AN1ME2U/diploma/project/project.png

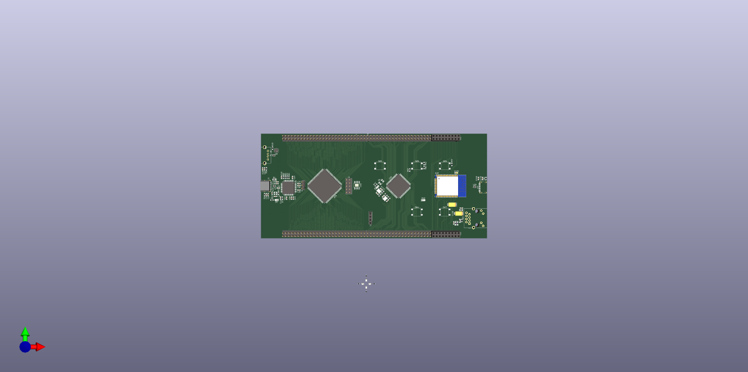
project/project.png
