AN1ME2U/diploma/(list of files, drawings)

Other design files:
project/atempt3.dsn
project/atempt4.dsn
project/atempt5.dsn
project/atempt6.dsn
project/atempt7.dsn
project/atempt8.dsn
project/atempt9.dsn
project/atempt10.dsn
project/atempt11.dsn
project/atempt12.dsn
project/atempt13.dsn
project/atempt14.dsn
project/atempt15.dsn
project/atempt16.dsn
project/project2.dsn
project/project.dsn
