AN1ME2U/diploma/project_old/project.kicad_pcb

## KiCad design project_old/project.kicad_pcb (2022-04-16, an earlier design)

Schematic: project.kicad_sch

Parts:
C1, C9, C10, C18, C19, C20, C21, C22, C24, C25, C26, C27, C28, C29, C30: 0.1u; C_0603_1608Metric_Pad1.08x0.95mm_HandSolder
C2, C3, C11, C12: 10u; CP_EIA-6032-15_Kemet-U_Pad2.25x2.35mm_HandSolder
C4, C23: 0.001u; C_0603_1608Metric_Pad1.08x0.95mm_HandSolder
C5, C6, C14, C15: 22u; CP_EIA-6032-15_Kemet-U_Pad2.25x2.35mm_HandSolder
C7, C8, C16, C17: 0.1u; C_0805_2012Metric_Pad1.18x1.45mm_HandSolder
C13: 1u; C_0603_1608Metric_Pad1.08x0.95mm_HandSolder
D1: D; D_0805_2012Metric_Pad1.15x1.40mm_HandSolder
D2: LED; LED_0805_2012Metric_Pad1.15x1.40mm_HandSolder
J1: USB_C_Receptacle_USB2.0; USB_C_Receptacle_HRO_TYPE-C-31-M-12
J2: Conn_01x03; PinHeader_1x03_P2.54mm_Vertical
J3: USB_A; USB_A_Molex_67643_Horizontal
L1, L2, L3, L4: 220; L_2010_5025Metric_Pad1.52x2.65mm_HandSolder
R1, R3, R9: 1M; R_0603_1608Metric_Pad0.98x0.95mm_HandSolder
R2, R4, R5, R6: 4.7k; R_0603_1608Metric_Pad0.98x0.95mm_HandSolder
R7: 9.53; R_0603_1608Metric_Pad0.98x0.95mm_HandSolder
R8: 4K; R_0603_1608Metric_Pad0.98x0.95mm_HandSolder
R10: 24k9; R_0603_1608Metric_Pad0.98x0.95mm_HandSolder
U1: AMS1117-5.0; SOT-223-3_TabPin2
U2, U5: AMS1117-3.3; SOT-223-3_TabPin2
U3, U7: USBLC6-2P6; SOT-666
U4: AMS1117-1.5; SOT-223-3_TabPin2
U6: TUSB4041I; HTQFP-64-1EP_10x10mm_P0.5mm_EP8x8mm_Mask4.4x4.4mm_ThermalVi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
U8: TPS2560; VSON-10-1EP_3x3mm_P0.5mm_EP1.65x2.4mm
Y1: Crystal_GND23; Crystal_SMD_2520-4Pin_2.5x2.0mm

Connections:
1V1_pereph: C24.1, C25.1, C26.1, C27.1, C28.1, C29.1, C30.1, U6.19 (VDD), U6.25 (VDD), U6.37 (VDD), U6.45 (VDD), U6.53 (VDD), U6.60 (VDD), U6.63 (VDD)
1V2_pereph: L3.2
3V3_header: L2.2; also elsewhere on the board
3V3_pereph: C18.1, C19.1, C20.1, C22.1, L4.2, U6.2 (VDD33), U6.20 (VDD33), U6.31 (VDD33), U6.48 (VDD33); also elsewhere on the board
5V_header: L1.2; also elsewhere on the board
+5V: C2.1, C3.1, C11.1, C12.1, D1.1 (K), R8.1, U1.3 (VI), U2.3 (VI), U3.5 (VBUS), U4.3 (VI), U5.3 (VI), U6.16 (USB_VBUS), U8.2 (IN), U8.3 (IN); also elsewhere on the board
/USB_MAIN_N: J1.A7 (D-), J1.B7 (D-), U3.3 (I/O2)
/USB_MAIN_P: J1.A6 (D+), J1.B6 (D+), U3.1 (I/O1)
GND: C1.2, C2.2, C3.2, C4.2, C5.2, C6.2, C7.2, C8.2, C9.2, C10.2, C11.2, C12.2, C13.1, C14.2, C15.2, C16.2, C17.2, C18.2, C19.2, C20.2, C21.2, C22.2, C23.2, C24.2, C25.2, C26.2, C27.2, C28.2, C29.2, C30.2, D2.1 (K), J1.A1 (GND), J1.A12 (GND), J1.B1 (GND), J1.B12 (GND), J3.4 (GND), R1.2, R2.2, R4.2, R5.2, R6.2, R7.2, R9.2, R10.2, U1.1 (GND), U2.1 (GND), U3.2 (GND), U4.1 (GND), U5.1 (GND), U6.65 (VSS), U7.2 (GND), U8.1 (GND), Y1.2, Y1.4; also elsewhere on the board
unnamed: C1.1, C4.1, J1.S1 (SHIELD), R1.1
unnamed: C5.1, C7.1, L1.1, U1.2 (VO)
unnamed: C6.1, C8.1, L2.1, U2.2 (VO)
unnamed: C9.1, R3.1, U6.30 (XI), Y1.1
unnamed: C10.1, R3.2, U6.29 (XO), Y1.3
unnamed: C13.2, U6.18 (GRSTz)
unnamed: C14.1, C16.1, L3.1, U4.2 (VO)
unnamed: C15.1, C17.1, L4.1, U5.2 (VO)
unnamed: C21.1, C23.1, J3.5 (Shield), R9.1
unnamed: D1.2 (A), J1.A4 (VBUS), J1.A9 (VBUS), J1.B4 (VBUS), J1.B9 (VBUS)
unnamed: D2.2 (A), R8.2
unnamed: J2.1, U6.7 (SMBUSz)
unnamed: J2.2, U6.6 (SCL/SMBCLK)
unnamed: J2.3, U6.5 (SDA/SMBDAT)
unnamed: R2.1, U6.10 (GANGED/SMBA2/HS_UP)
unnamed: R4.1, U6.8 (FULLPWRMGMTz/SMBA1)
unnamed: R5.1, U6.13 (AUTOENz/HS_SUSPEND)
unnamed: R6.1, U6.17 (TEST)
unnamed: R7.1, U6.32 (USB_R1)
unnamed: R10.1, U8.7 (ILM)
unnamed: U3.4 (I/O2), U6.22 (USB_DM_UP)
unnamed: U3.6 (I/O1), U6.21 (USB_DP_UP)
USB1_DN: U6.34 (USB_DM_DN1); also elsewhere on the board
USB1_DP: U6.33 (USB_DP_DN1); also elsewhere on the board
USB2_DN: U6.42 (USB_DM_DN2); also elsewhere on the board
USB2_DP: U6.41 (USB_DP_DN2); also elsewhere on the board
USB3_DN: U6.50 (USB_DM_DN3); also elsewhere on the board
USB3_DP: U6.49 (USB_DP_DN3); also elsewhere on the board
USB4_DN: J3.2 (D-), U6.57 (USB_DM_DN4), U7.1 (I/O1), U7.6 (I/O1)
USB4_DP: J3.3 (D+), U6.56 (USB_DP_DN4), U7.3 (I/O2), U7.4 (I/O2)
USB4_VBUS: J3.1 (VBUS), U7.5 (VBUS), U8.9 (OUT1)
USB_OTG_VBUS: U8.8 (OUT2); also elsewhere on the board

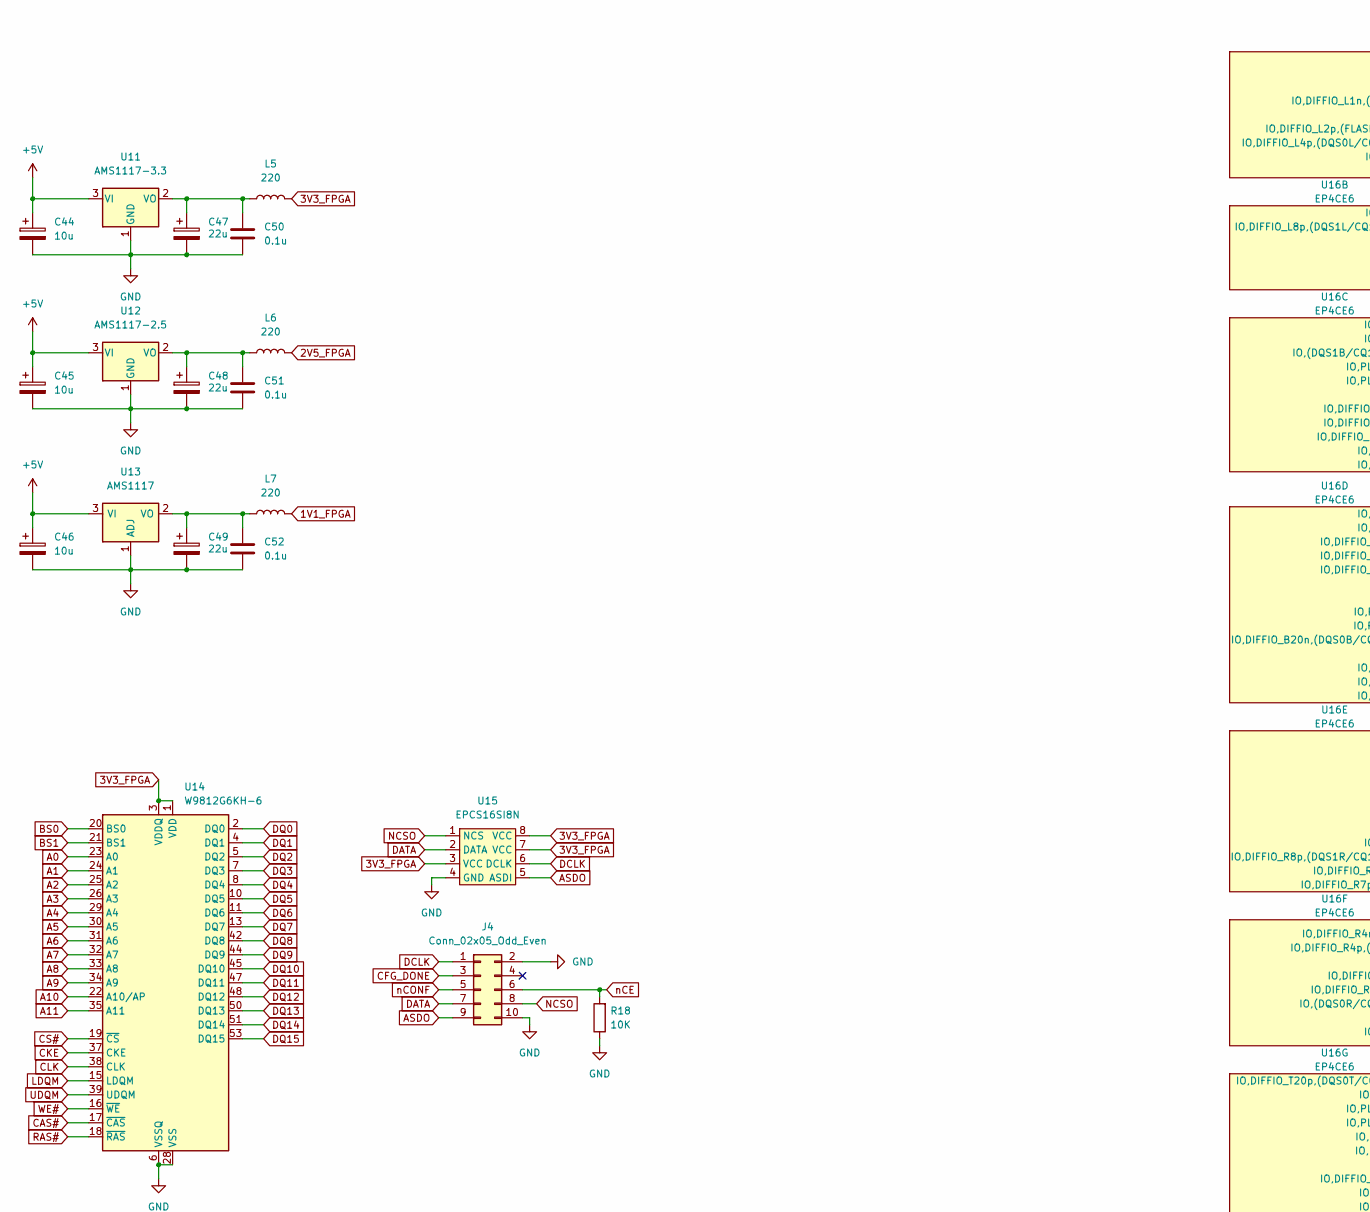
[picture p4: schematic FPGA.kicad_sch, part in row 1, column 1]

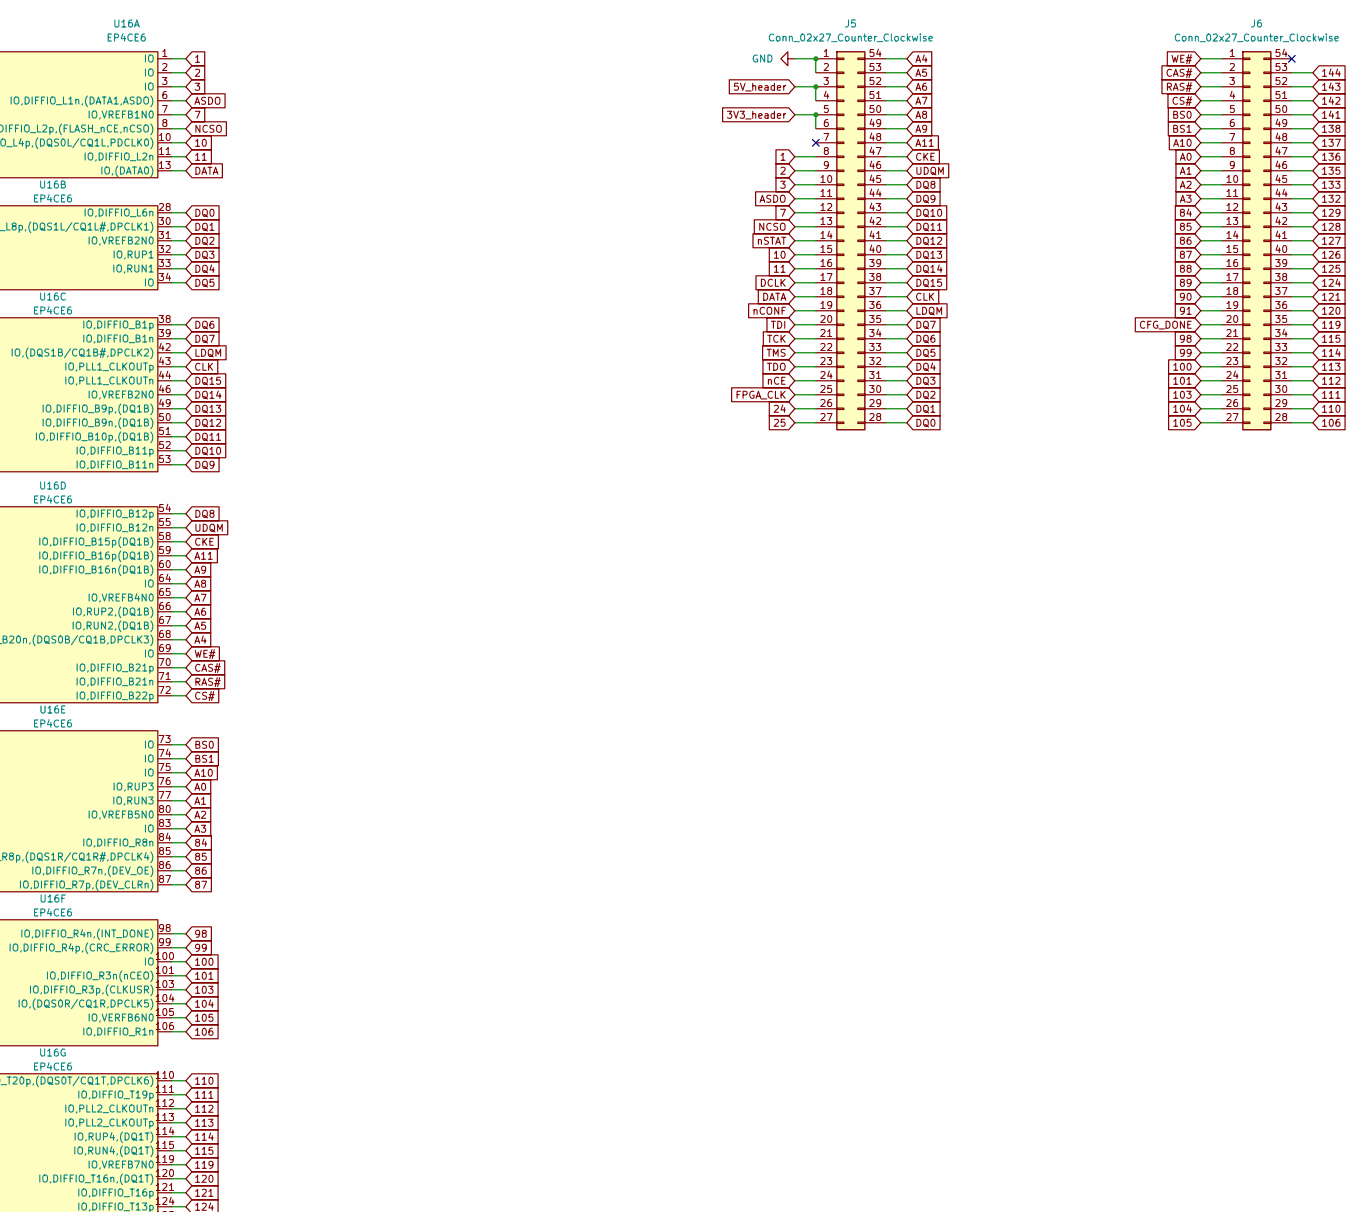
[picture p5: schematic FPGA.kicad_sch, part in row 1, column 2]

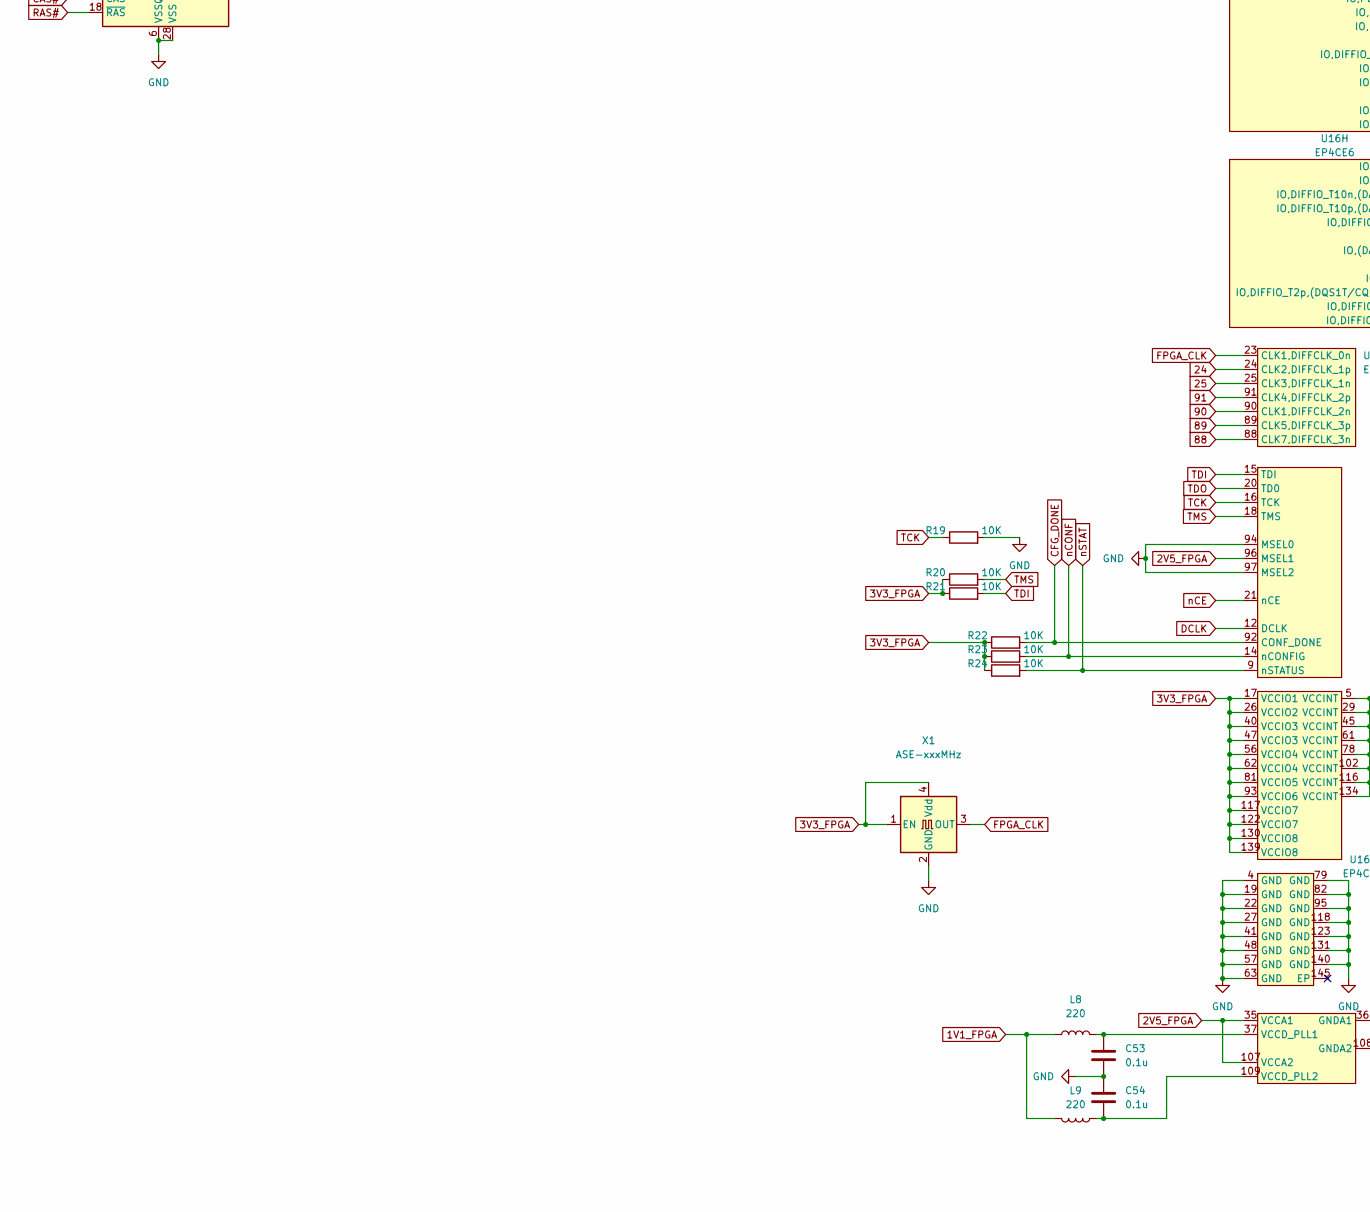
[picture p6: schematic FPGA.kicad_sch, part in row 2, column 1]

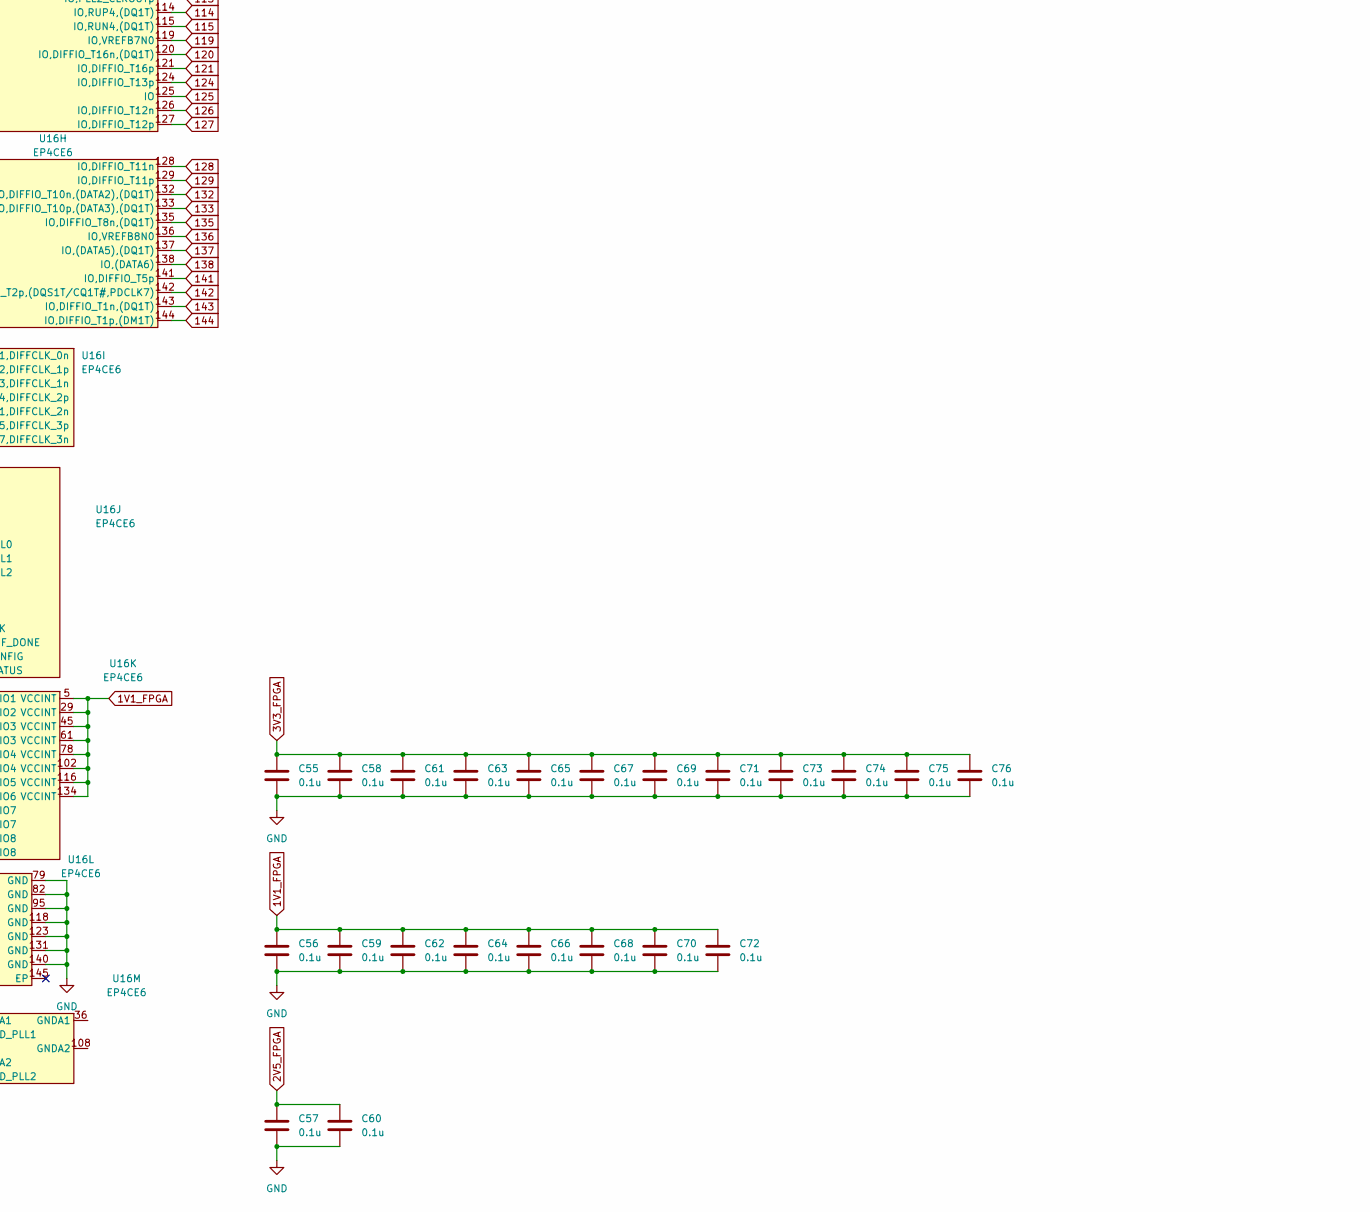
[picture p7: schematic FPGA.kicad_sch, part in row 2, column 2]

Parts:
C44, C45, C46: 10u; CP_EIA-6032-15_Kemet-U_Pad2.25x2.35mm_HandSolder
C47, C48, C49: 22u; CP_EIA-6032-15_Kemet-U_Pad2.25x2.35mm_HandSolder
C50, C51, C52: 0.1u; C_0805_2012Metric_Pad1.18x1.45mm_HandSolder
C53, C54, C55, C56, C57, C58, C59, C60, C61, C62, C63, C64, C65, C66, C67, C68, C69, C70, C71, C72, C73, C74, C75, C76: 0.1u; C_0603_1608Metric_Pad1.08x0.95mm_HandSolder
J4: Conn_02x05_Odd_Even; PinHeader_2x05_P2.54mm_Vertical
J5, J6: Conn_02x27_Counter_Clockwise; PinHeader_2x27_P2.54mm_Vertical
L5, L6, L7, L8, L9: 220; L_2010_5025Metric_Pad1.52x2.65mm_HandSolder
R18, R19, R20, R21, R22, R23, R24: 10K; R_0603_1608Metric_Pad0.98x0.95mm_HandSolder
U11: AMS1117-3.3; SOT-223-3_TabPin2
U12: AMS1117-2.5; SOT-223-3_TabPin2
U13: AMS1117; SOT-223-3_TabPin2
U14: W9812G6KH-6; TSOP-II-54_22.2x10.16mm_P0.8mm
U15: EPCS16SI8N; SOIC-8-1EP_3.9x4.9mm_P1.27mm_EP2.29x3mm
U16: EP4CE6; TQFP-144_20x20mm_P0.5mm
X1: ASE-xxxMHz; Oscillator_SMD_Abracon_ASE-4Pin_3.2x2.5mm

Connections:
1: J5.8, U16.1 (IO)
1V1_FPGA: C56.1, C59.1, C62.1, C64.1, C66.1, C68.1, C70.1, C72.1, L7.2, L8.1, L9.2, U16.5 (VCCINT), U16.29 (VCCINT), U16.45 (VCCINT), U16.61 (VCCINT), U16.78 (VCCINT), U16.102 (VCCINT), U16.116 (VCCINT), U16.134 (VCCINT)
2: J5.9, U16.2 (IO)
2V5_FPGA: C57.1, C60.1, L6.2, U16.35 (VCCA1), U16.96 (MSEL1), U16.107 (VCCA2)
3: J5.10, U16.3 (IO)
3V3_FPGA: C55.1, C58.1, C61.1, C63.1, C65.1, C67.1, C69.1, C71.1, C73.1, C74.1, C75.1, C76.1, L5.2, R20.1, R21.1, R22.1, R23.1, R24.1, U14.1 (VDD), U14.3 (VDDQ), U14.9 (VDDQ), U14.14 (VDD), U14.27 (VDD), U14.43 (VDDQ), U14.49 (VDDQ), U15.3 (VCC), U15.7 (VCC), U15.8 (VCC), U16.17 (VCCIO1), U16.26 (VCCIO2), U16.40 (VCCIO3), U16.47 (VCCIO3), U16.56 (VCCIO4), U16.62 (VCCIO4), U16.81 (VCCIO5), U16.93 (VCCIO6), U16.117 (VCCIO7), U16.122 (VCCIO7), U16.130 (VCCIO8), U16.139 (VCCIO8), X1.1 (EN), X1.4 (Vdd)
3V3_header: J5.5, J5.6; also elsewhere on the board
5V_header: J5.3, J5.4; also elsewhere on the board
7: J5.12, U16.7 (IO,VREFB1N0)
10: J5.15, U16.10 (IO,DIFFIO_L4p,(DQS0L/CQ1L,PDCLK0))
11: J5.16, U16.11 (IO,DIFFIO_L2n)
24: J5.26, U16.24 (CLK2,DIFFCLK_1p)
25: J5.27, U16.25 (CLK3,DIFFCLK_1n)
84: J6.12, U16.84 (IO,DIFFIO_R8n)
85: J6.13, U16.85 (IO,DIFFIO_R8p,(DQS1R/CQ1R#,DPCLK4))
86: J6.14, U16.86 (IO,DIFFIO_R7n,(DEV_OE))
87: J6.15, U16.87 (IO,DIFFIO_R7p,(DEV_CLRn))
88: J6.16, U16.88 (CLK7,DIFFCLK_3n)
89: J6.17, U16.89 (CLK5,DIFFCLK_3p)
90: J6.18, U16.90 (CLK1,DIFFCLK_2n)
91: J6.19, U16.91 (CLK4,DIFFCLK_2p)
98: J6.21, U16.98 (IO,DIFFIO_R4n,(INT_DONE))
99: J6.22, U16.99 (IO,DIFFIO_R4p,(CRC_ERROR))
100: J6.23, U16.100 (IO)
101: J6.24, U16.101 (IO,DIFFIO_R3n(nCEO))
103: J6.25, U16.103 (IO,DIFFIO_R3p,(CLKUSR))
104: J6.26, U16.104 (IO,(DQS0R/CQ1R,DPCLK5))
105: J6.27, U16.105 (IO,VERFB6N0)
106: J6.28, U16.106 (IO,DIFFIO_R1n)
110: J6.29, U16.110 (IO,DIFFIO_T20p,(DQS0T/CQ1T,DPCLK6))
111: J6.30, U16.111 (IO,DIFFIO_T19p)
112: J6.31, U16.112 (IO,PLL2_CLKOUTn)
113: J6.32, U16.113 (IO,PLL2_CLKOUTp)
114: J6.33, U16.114 (IO,RUP4,(DQ1T))
115: J6.34, U16.115 (IO,RUN4,(DQ1T))
119: J6.35, U16.119 (IO,VREFB7N0)
120: J6.36, U16.120 (IO,DIFFIO_T16n,(DQ1T))
121: J6.37, U16.121 (IO,DIFFIO_T16p)
124: J6.38, U16.124 (IO,DIFFIO_T13p)
125: J6.39, U16.125 (IO)
126: J6.40, U16.126 (IO,DIFFIO_T12n)
127: J6.41, U16.127 (IO,DIFFIO_T12p)
128: J6.42, U16.128 (IO,DIFFIO_T11n)
129: J6.43, U16.129 (IO,DIFFIO_T11p)
132: J6.44, U16.132 (IO,DIFFIO_T10n,(DATA2),(DQ1T))
133: J6.45, U16.133 (IO,DIFFIO_T10p,(DATA3),(DQ1T))
135: J6.46, U16.135 (IO,DIFFIO_T8n,(DQ1T))
136: J6.47, U16.136 (IO,VREFB8N0)
137: J6.48, U16.137 (IO,(DATA5),(DQ1T))
138: J6.49, U16.138 (IO,(DATA6))
141: J6.50, U16.141 (IO,DIFFIO_T5p)
142: J6.51, U16.142 (IO,DIFFIO_T2p,(DQS1T/CQ1T#,PDCLK7))
143: J6.52, U16.143 (IO,DIFFIO_T1n,(DQ1T))
144: J6.53, U16.144 (IO,DIFFIO_T1p,(DM1T))
+5V: C44.1, C45.1, C46.1, U11.3 (VI), U12.3 (VI), U13.3 (VI); also elsewhere on the board
A0: J6.8, U14.23 (A0), U16.76 (IO,RUP3)
A1: J6.9, U14.24 (A1), U16.77 (IO,RUN3)
A2: J6.10, U14.25 (A2), U16.80 (IO,VREFB5N0)
A3: J6.11, U14.26 (A3), U16.83 (IO)
A4: J5.54, U14.29 (A4), U16.68 (IO,DIFFIO_B20n,(DQS0B/CQ1B,DPCLK3))
A5: J5.53, U14.30 (A5), U16.67 (IO,RUN2,(DQ1B))
A6: J5.52, U14.31 (A6), U16.66 (IO,RUP2,(DQ1B))
A7: J5.51, U14.32 (A7), U16.65 (IO,VREFB4N0)
A8: J5.50, U14.33 (A8), U16.64 (IO)
A9: J5.49, U14.34 (A9), U16.60 (IO,DIFFIO_B16n(DQ1B))
A10: J6.7, U14.22 (A10/AP), U16.75 (IO)
A11: J5.48, U14.35 (A11), U16.59 (IO,DIFFIO_B16p(DQ1B))
ASDO: J4.9, J5.11, U15.5 (ASDI), U16.6 (IO,DIFFIO_L1n,(DATA1,ASDO))
BS0: J6.5, U14.20 (BS0), U16.73 (IO)
BS1: J6.6, U14.21 (BS1), U16.74 (IO)
CAS#: J6.2, U14.17 (~CAS), U16.70 (IO,DIFFIO_B21p)
CFG_DONE: J4.3, J6.20, R22.2, U16.92 (CONF_DONE)
CKE: J5.47, U14.37 (CKE), U16.58 (IO,DIFFIO_B15p(DQ1B))
CLK: J5.37, U14.38 (CLK), U16.43 (IO,PLL1_CLKOUTp)
CS#: J6.4, U14.19 (~CS), U16.72 (IO,DIFFIO_B22p)
DATA: J4.7, J5.18, U15.2 (DATA), U16.13 (IO,(DATA0))
DCLK: J4.1, J5.17, U15.6 (DCLK), U16.12 (DCLK)
DQ0: J5.28, U14.2 (DQ0), U16.28 (IO,DIFFIO_L6n)
DQ1: J5.29, U14.4 (DQ1), U16.30 (IO,DIFFIO_L8p,(DQS1L/CQ1L#,DPCLK1))
DQ2: J5.30, U14.5 (DQ2), U16.31 (IO,VREFB2N0)
DQ3: J5.31, U14.7 (DQ3), U16.32 (IO,RUP1)
DQ4: J5.32, U14.8 (DQ4), U16.33 (IO,RUN1)
DQ5: J5.33, U14.10 (DQ5), U16.34 (IO)
DQ6: J5.34, U14.11 (DQ6), U16.38 (IO,DIFFIO_B1p)
DQ7: J5.35, U14.13 (DQ7), U16.39 (IO,DIFFIO_B1n)
DQ8: J5.45, U14.42 (DQ8), U16.54 (IO,DIFFIO_B12p)
DQ9: J5.44, U14.44 (DQ9), U16.53 (IO,DIFFIO_B11n)
DQ10: J5.43, U14.45 (DQ10), U16.52 (IO,DIFFIO_B11p)
DQ11: J5.42, U14.47 (DQ11), U16.51 (IO,DIFFIO_B10p,(DQ1B))
DQ12: J5.41, U14.48 (DQ12), U16.50 (IO,DIFFIO_B9n,(DQ1B))
DQ13: J5.40, U14.50 (DQ13), U16.49 (IO,DIFFIO_B9p,(DQ1B))
DQ14: J5.39, U14.51 (DQ14), U16.46 (IO,VREFB2N0)
DQ15: J5.38, U14.53 (DQ15), U16.44 (IO,PLL1_CLKOUTn)
FPGA_CLK: J5.25, U16.23 (CLK1,DIFFCLK_0n), X1.3 (OUT)
GND: C44.2, C45.2, C46.2, C47.2, C48.2, C49.2, C50.2, C51.2, C52.2, C53.2, C54.1, C55.2, C56.2, C57.2, C58.2, C59.2, C60.2, C61.2, C62.2, C63.2, C64.2, C65.2, C66.2, C67.2, C68.2, C69.2, C70.2, C71.2, C72.2, C73.2, C74.2, C75.2, C76.2, J4.2, J4.10, J5.1, J5.2, R18.1, R19.2, U11.1 (GND), U12.1 (GND), U13.1 (ADJ), U14.6 (VSSQ), U14.12 (VSSQ), U14.28 (VSS), U14.41 (VSS), U14.46 (VSSQ), U14.52 (VSSQ), U14.54 (VSS), U15.4 (GND), U16.4 (GND), U16.19 (GND), U16.22 (GND), U16.27 (GND), U16.41 (GND), U16.48 (GND), U16.57 (GND), U16.63 (GND), U16.79 (GND), U16.82 (GND), U16.94 (MSEL0), U16.95 (GND), U16.97 (MSEL2), U16.118 (GND), U16.123 (GND), U16.131 (GND), U16.140 (GND), X1.2 (GND); also elsewhere on the board
LDQM: J5.36, U14.15 (LDQM), U16.42 (IO,(DQS1B/CQ1B#,DPCLK2))
NCSO: J4.8, J5.13, U15.1 (NCS), U16.8 (IO,DIFFIO_L2p,(FLASH_nCE,nCSO))
unnamed: C47.1, C50.1, L5.1, U11.2 (VO)
unnamed: C48.1, C51.1, L6.1, U12.2 (VO)
unnamed: C49.1, C52.1, L7.1, U13.2 (VO)
unnamed: C53.1, L8.2, U16.37 (VCCD_PLL1)
unnamed: C54.2, L9.1, U16.109 (VCCD_PLL2)
RAS#: J6.3, U14.18 (~RAS), U16.71 (IO,DIFFIO_B21n)
TCK: J5.21, R19.1, U16.16 (TCK)
TDI: J5.20, R21.2, U16.15 (TDI)
TDO: J5.23, U16.20 (TD0)
TMS: J5.22, R20.2, U16.18 (TMS)
UDQM: J5.46, U14.39 (UDQM), U16.55 (IO,DIFFIO_B12n)
WE#: J6.1, U14.16 (~WE), U16.69 (IO)
nCE: J4.6, J5.24, R18.2, U16.21 (nCE)
nCONF: J4.5, J5.19, R23.2, U16.14 (nCONFIG)
nSTAT: J5.14, R24.2, U16.9 (nSTATUS)

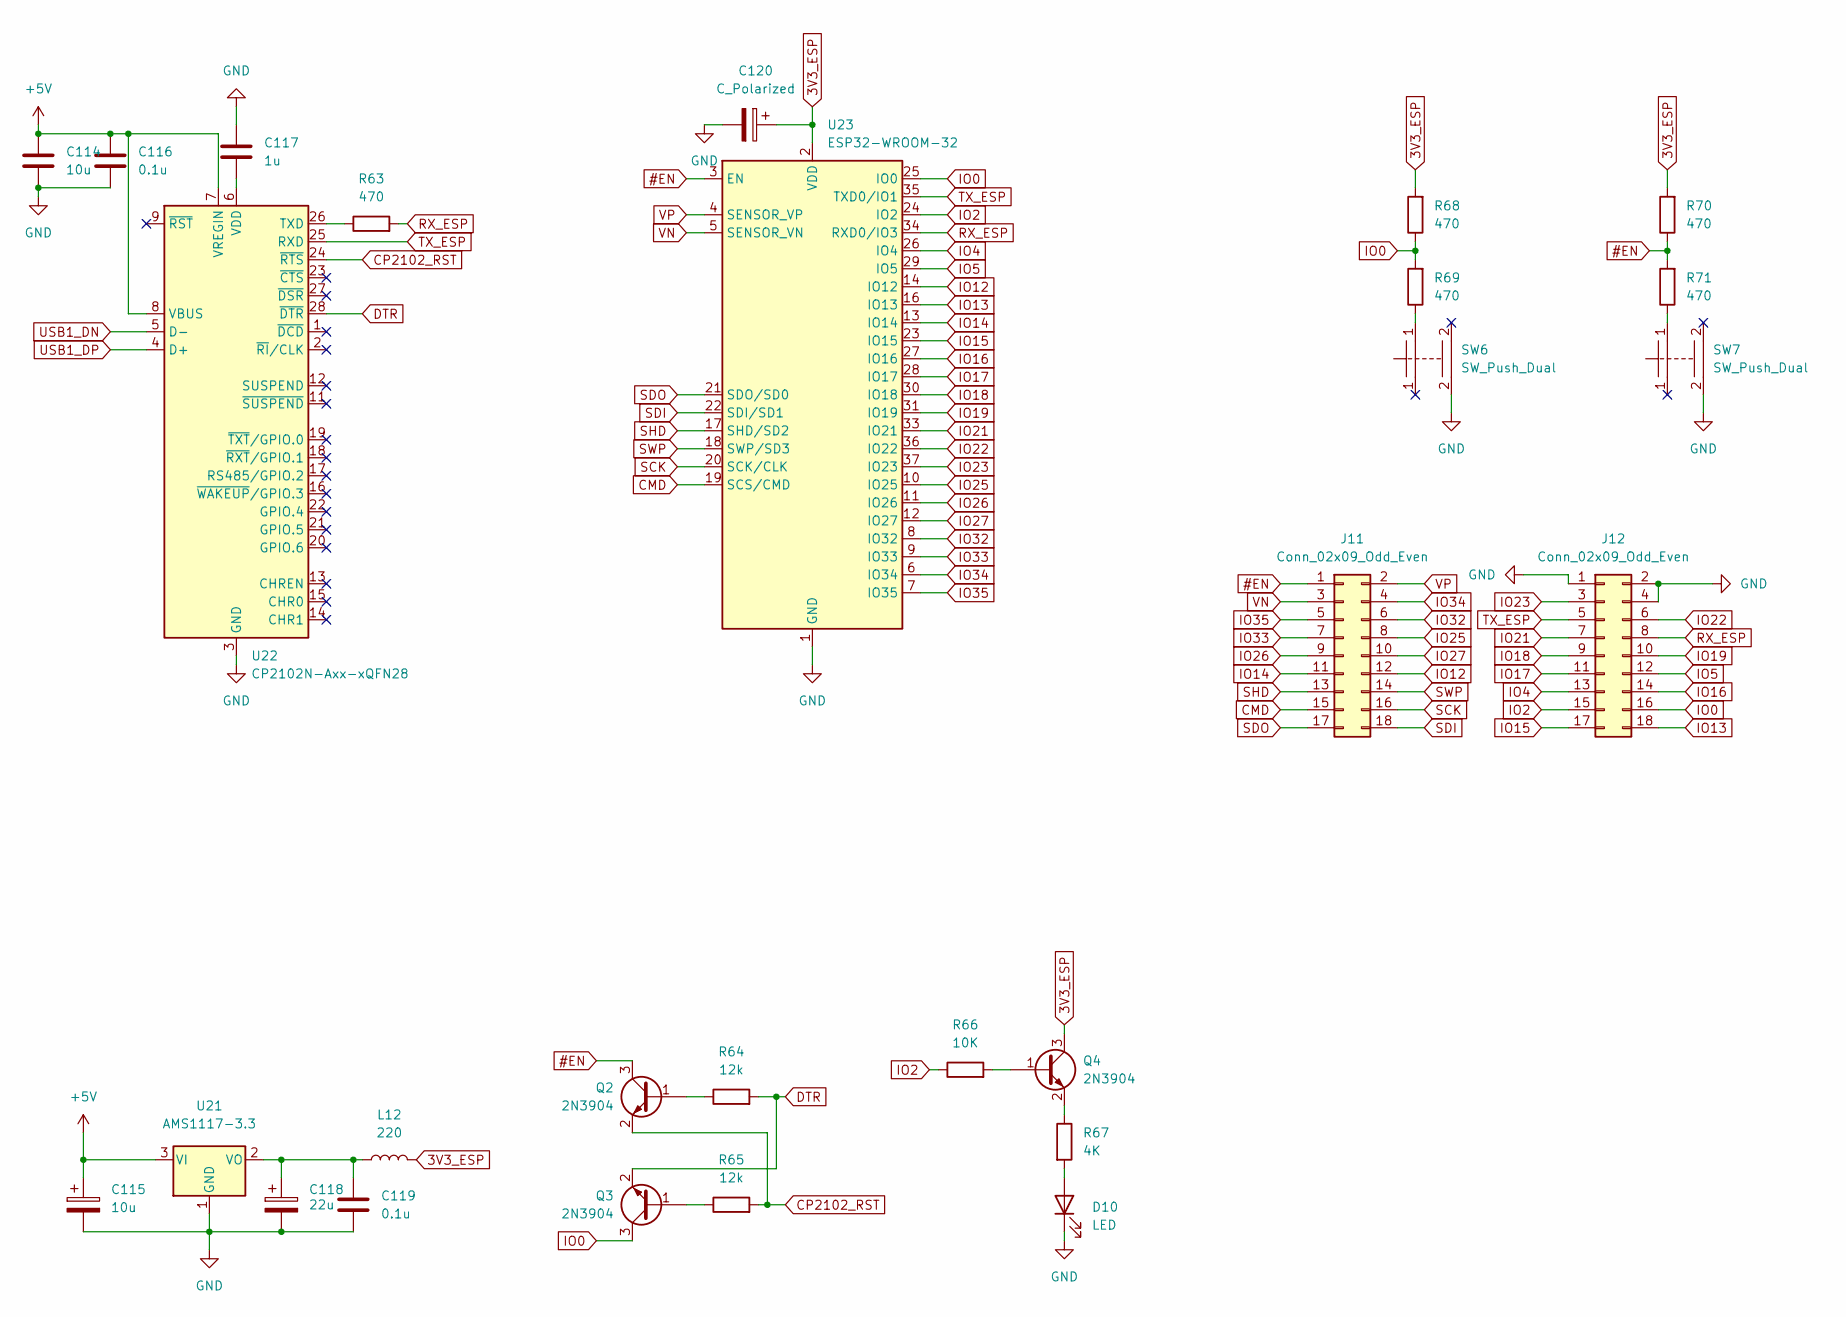
[picture p8: schematic esp32.kicad_sch]

Parts:
C114: 10u; C_0603_1608Metric_Pad1.08x0.95mm_HandSolder
C115: 10u; CP_EIA-6032-15_Kemet-U_Pad2.25x2.35mm_HandSolder
C116: 0.1u; C_0603_1608Metric_Pad1.08x0.95mm_HandSolder
C117: 1u; C_0603_1608Metric_Pad1.08x0.95mm_HandSolder
C118: 22u; CP_EIA-6032-15_Kemet-U_Pad2.25x2.35mm_HandSolder
C119: 0.1u; C_0805_2012Metric_Pad1.18x1.45mm_HandSolder
C120: C_Polarized; CP_EIA-1608-08_AVX-J_Pad1.25x1.05mm_HandSolder
D10: LED; LED_0805_2012Metric_Pad1.15x1.40mm_HandSolder
J11, J12: Conn_02x09_Odd_Even; PinSocket_2x09_P2.54mm_Vertical
L12: 220; L_2010_5025Metric_Pad1.52x2.65mm_HandSolder
Q2, Q3, Q4: 2N3904; SOT-23
R63, R68, R69, R70, R71: 470; R_0603_1608Metric_Pad0.98x0.95mm_HandSolder
R64, R65: 12k; R_0603_1608Metric_Pad0.98x0.95mm_HandSolder
R66: 10K; R_0603_1608Metric_Pad0.98x0.95mm_HandSolder
R67: 4K; R_0603_1608Metric_Pad0.98x0.95mm_HandSolder
SW6, SW7: SW_Push_Dual; SW_Push_1P1T_NO_6x6mm_H9.5mm
U21: AMS1117-3.3; SOT-223-3_TabPin2
U22: CP2102N-Axx-xQFN28; QFN-28-1EP_5x5mm_P0.5mm_EP3.35x3.35mm_ThermalVias
U23: ESP32-WROOM-32

Connections:
3V3_ESP: C120.1, L12.2, Q4.3 (C), R68.2, R70.2, U23.2 (VDD)
#EN: J11.1, Q2.3 (C), R70.1, R71.2, U23.3 (EN)
+5V: C114.1, C115.1, C116.1, U21.3 (VI), U22.7 (VREGIN), U22.8 (VBUS); also elsewhere on the board
CMD: J11.15, U23.19 (SCS/CMD)
CP2102_RST: Q2.2 (E), R65.2, U22.24 (~RTS)
DTR: Q3.2 (E), R64.2, U22.28 (~DTR)
GND: C114.2, C115.2, C116.2, C117.1, C118.2, C119.2, C120.2, D10.1 (K), J12.1, J12.2, J12.4, SW6.2, SW7.2, U21.1 (GND), U22.3 (GND), U22.29 (GND), U23.1 (GND), U23.15 (GND), U23.38 (GND), U23.39 (GND); also elsewhere on the board
IO0: J12.16, Q3.3 (C), R68.1, R69.2, U23.25 (IO0)
IO2: J12.15, R66.1, U23.24 (IO2)
IO4: J12.13, U23.26 (IO4)
IO5: J12.12, U23.29 (IO5)
IO12: J11.12, U23.14 (IO12)
IO13: J12.18, U23.16 (IO13)
IO14: J11.11, U23.13 (IO14)
IO15: J12.17, U23.23 (IO15)
IO16: J12.14, U23.27 (IO16)
IO17: J12.11, U23.28 (IO17)
IO18: J12.9, U23.30 (IO18)
IO19: J12.10, U23.31 (IO19)
IO21: J12.7, U23.33 (IO21)
IO22: J12.6, U23.36 (IO22)
IO23: J12.3, U23.37 (IO23)
IO25: J11.8, U23.10 (IO25)
IO26: J11.9, U23.11 (IO26)
IO27: J11.10, U23.12 (IO27)
IO32: J11.6, U23.8 (IO32)
IO33: J11.7, U23.9 (IO33)
IO34: J11.4, U23.6 (IO34)
IO35: J11.5, U23.7 (IO35)
unnamed: C117.2, U22.6 (VDD)
unnamed: C118.1, C119.1, L12.1, U21.2 (VO)
unnamed: D10.2 (A), R67.2
unnamed: Q2.1 (B), R64.1
unnamed: Q3.1 (B), R65.1
unnamed: Q4.1 (B), R66.2
unnamed: Q4.2 (E), R67.1
unnamed: R63.1, U22.26 (TXD)
unnamed: R69.1, SW6.1
unnamed: R71.1, SW7.1
RX_ESP: J12.8, R63.2, U23.34 (RXD0/IO3)
SCK: J11.16, U23.20 (SCK/CLK)
SDI: J11.18, U23.22 (SDI/SD1)
SDO: J11.17, U23.21 (SDO/SD0)
SHD: J11.13, U23.17 (SHD/SD2)
SWP: J11.14, U23.18 (SWP/SD3)
TX_ESP: J12.5, U22.25 (RXD), U23.35 (TXD0/IO1)
USB1_DN: U22.5 (D-); also elsewhere on the board
USB1_DP: U22.4 (D+); also elsewhere on the board
VN: J11.3, U23.5 (SENSOR_VN)
VP: J11.2, U23.4 (SENSOR_VP)

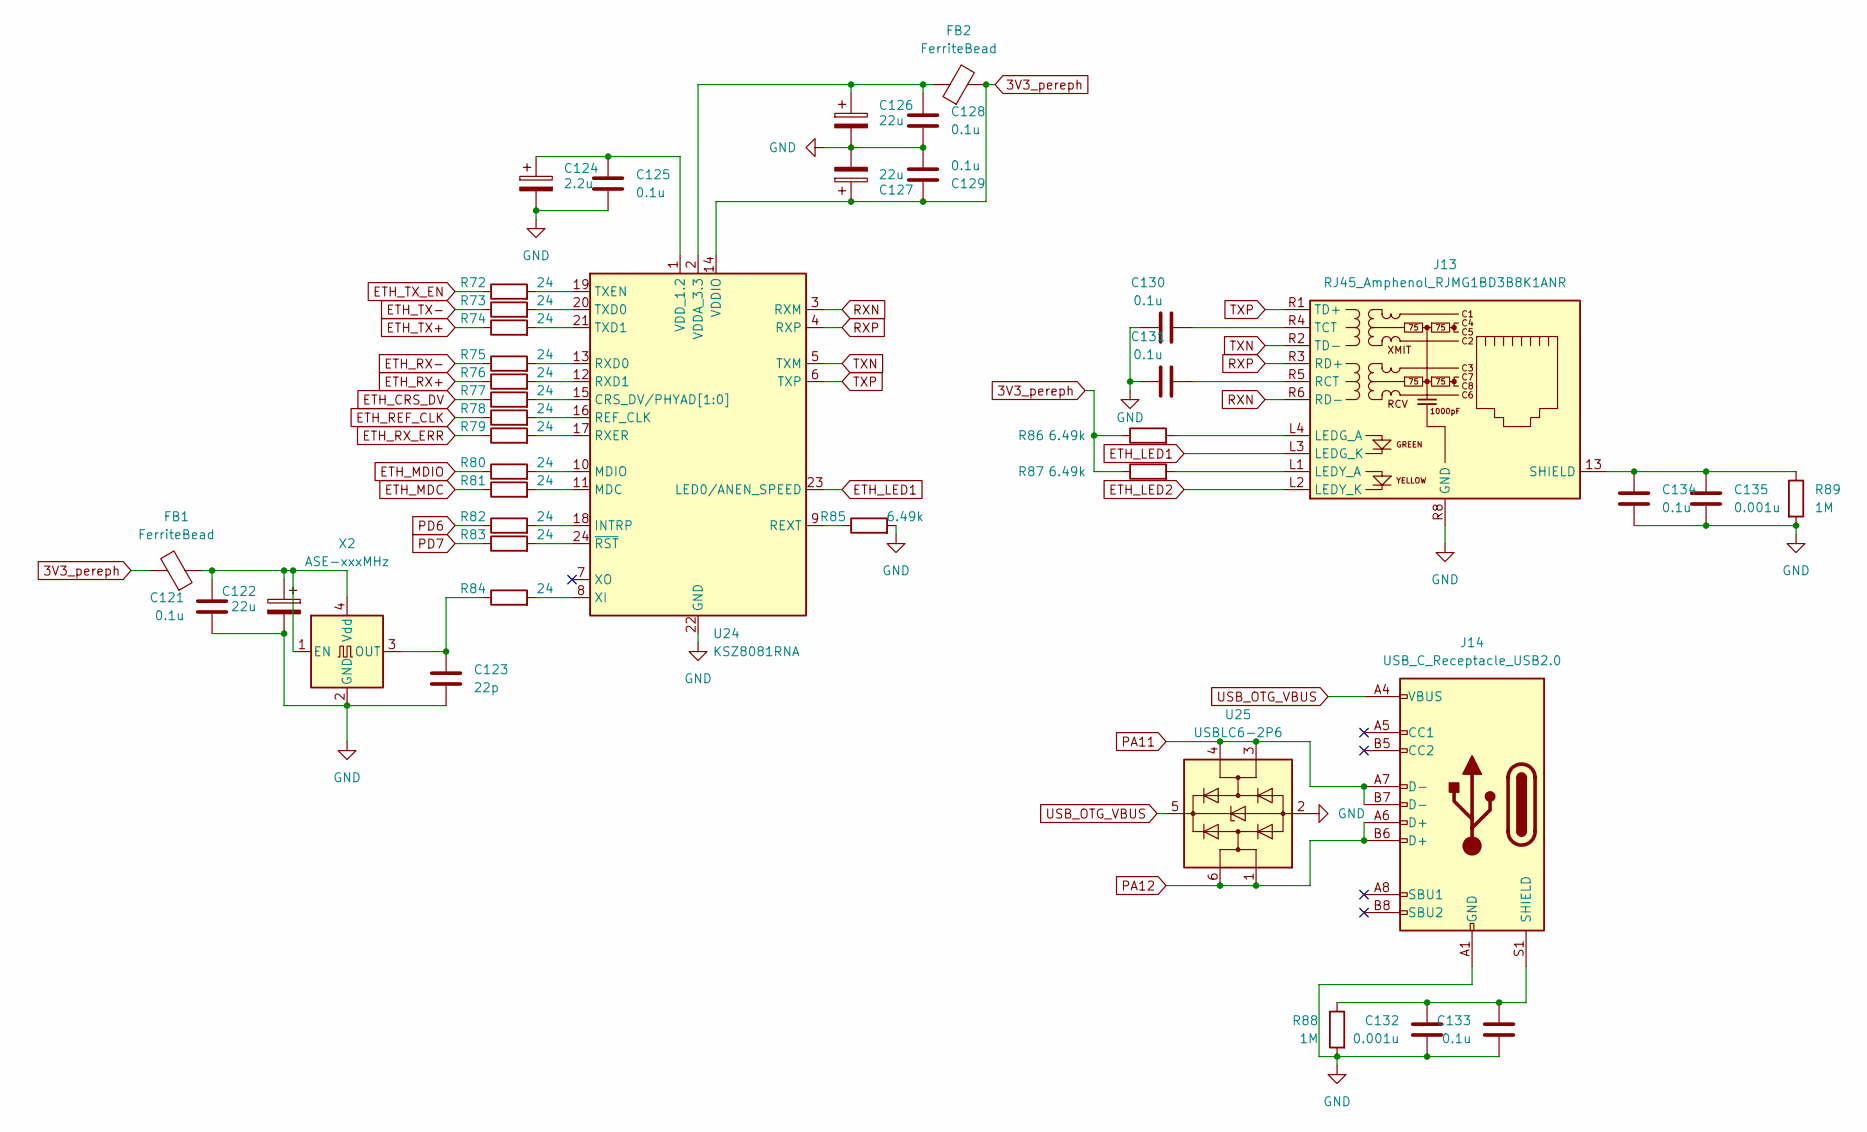
[picture p9: schematic stm32_ex.kicad_sch]

Parts:
C121, C125, C128, C129, C130, C131, C133, C134: 0.1u; C_0603_1608Metric_Pad1.08x0.95mm_HandSolder
C122, C126, C127: 22u; CP_EIA-6032-15_Kemet-U_Pad2.25x2.35mm_HandSolder
C123: 22p; C_0603_1608Metric_Pad1.08x0.95mm_HandSolder
C124: 2.2u; CP_EIA-1608-08_AVX-J
C132, C135: 0.001u; C_0603_1608Metric_Pad1.08x0.95mm_HandSolder
FB1, FB2: FerriteBead; L_0805_2012Metric_Pad1.05x1.20mm_HandSolder
J13: RJ45_Amphenol_RJMG1BD3B8K1ANR
J14: USB_C_Receptacle_USB2.0; USB_C_Receptacle_HRO_TYPE-C-31-M-12
R72, R73, R74, R75, R76, R77, R78, R79, R80, R81, R82, R83, R84: 24; R_0603_1608Metric_Pad0.98x0.95mm_HandSolder
R85, R86, R87: 6.49k; R_0603_1608Metric_Pad0.98x0.95mm_HandSolder
R88, R89: 1M; R_0603_1608Metric_Pad0.98x0.95mm_HandSolder
U24: KSZ8081RNA; QFN-24-1EP_4x4mm_P0.5mm_EP2.6x2.6mm_ThermalVias
U25: USBLC6-2P6; SOT-666
X2: ASE-xxxMHz; Oscillator_SMD_Abracon_ASE-4Pin_3.2x2.5mm

Connections:
3V3_pereph: C127.1, C129.1, FB1.2, FB2.2, R86.1, R87.1, U24.14 (VDDIO); also elsewhere on the board
ETH_CRS_DV: R77.1; also elsewhere on the board
ETH_LED1: J13.L3 (LEDG_K), U24.23 (LED0/ANEN_SPEED)
ETH_LED2: J13.L2 (LEDY_K); also elsewhere on the board
ETH_MDC: R81.1; also elsewhere on the board
ETH_MDIO: R80.1; also elsewhere on the board
ETH_REF_CLK: R78.1; also elsewhere on the board
ETH_RX+: R76.1; also elsewhere on the board
ETH_RX-: R75.1; also elsewhere on the board
ETH_RX_ERR: R79.1; also elsewhere on the board
ETH_TX+: R74.1; also elsewhere on the board
ETH_TX-: R73.1; also elsewhere on the board
ETH_TX_EN: R72.1; also elsewhere on the board
GND: C121.2, C122.2, C123.2, C124.2, C125.2, C126.2, C127.2, C128.2, C129.2, C130.1, C131.1, C132.2, C133.2, C134.2, C135.2, J13.R8 (GND), J14.A1 (GND), J14.A12 (GND), J14.B1 (GND), J14.B12 (GND), R85.2, R88.2, R89.2, U24.22 (GND), U24.25 (GND), U25.2 (GND), X2.2 (GND); also elsewhere on the board
unnamed: C123.1, R84.1, X2.3 (OUT)
unnamed: C124.1, C125.1, U24.1 (VDD_1.2)
unnamed: C126.1, C128.1, FB2.1, U24.2 (VDDA_3.3)
unnamed: C130.2, J13.R4 (TCT)
unnamed: C131.2, J13.R5 (RCT)
unnamed: C132.1, C133.1, J14.S1 (SHIELD), R88.1
unnamed: C134.1, C135.1, J13.13 (SHIELD), R89.1
unnamed: J13.L1 (LEDY_A), R87.2
unnamed: J13.L4 (LEDG_A), R86.2
unnamed: R72.2, U24.19 (TXEN)
unnamed: R73.2, U24.20 (TXD0)
unnamed: R74.2, U24.21 (TXD1)
unnamed: R75.2, U24.13 (RXD0)
unnamed: R76.2, U24.12 (RXD1)
unnamed: R77.2, U24.15 (CRS_DV/PHYAD[1:0])
unnamed: R78.2, U24.16 (REF_CLK)
unnamed: R79.2, U24.17 (RXER)
unnamed: R80.2, U24.10 (MDIO)
unnamed: R81.2, U24.11 (MDC)
unnamed: R82.2, U24.18 (INTRP)
unnamed: R83.2, U24.24 (~RST)
unnamed: R84.2, U24.8 (XI)
unnamed: R85.1, U24.9 (REXT)
unnamed: C121.1, C122.1, FB1.1, X2.1 (EN), X2.4 (Vdd)
PA11: J14.A7 (D-), J14.B7 (D-), U25.3 (I/O2), U25.4 (I/O2); also elsewhere on the board
PA12: J14.A6 (D+), J14.B6 (D+), U25.1 (I/O1), U25.6 (I/O1); also elsewhere on the board
PD6: R82.1; also elsewhere on the board
PD7: R83.1; also elsewhere on the board
RXN: J13.R6 (RD-), U24.3 (RXM)
RXP: J13.R3 (RD+), U24.4 (RXP)
TXN: J13.R2 (TD-), U24.5 (TXM)
TXP: J13.R1 (TD+), U24.6 (TXP)
USB_OTG_VBUS: J14.A4 (VBUS), J14.A9 (VBUS), J14.B4 (VBUS), J14.B9 (VBUS), U25.5 (VBUS); also elsewhere on the board
