AN1ME2U/diploma/project_old/project.kicad_pcb

## KiCad design project_old/project.kicad_pcb (continued)

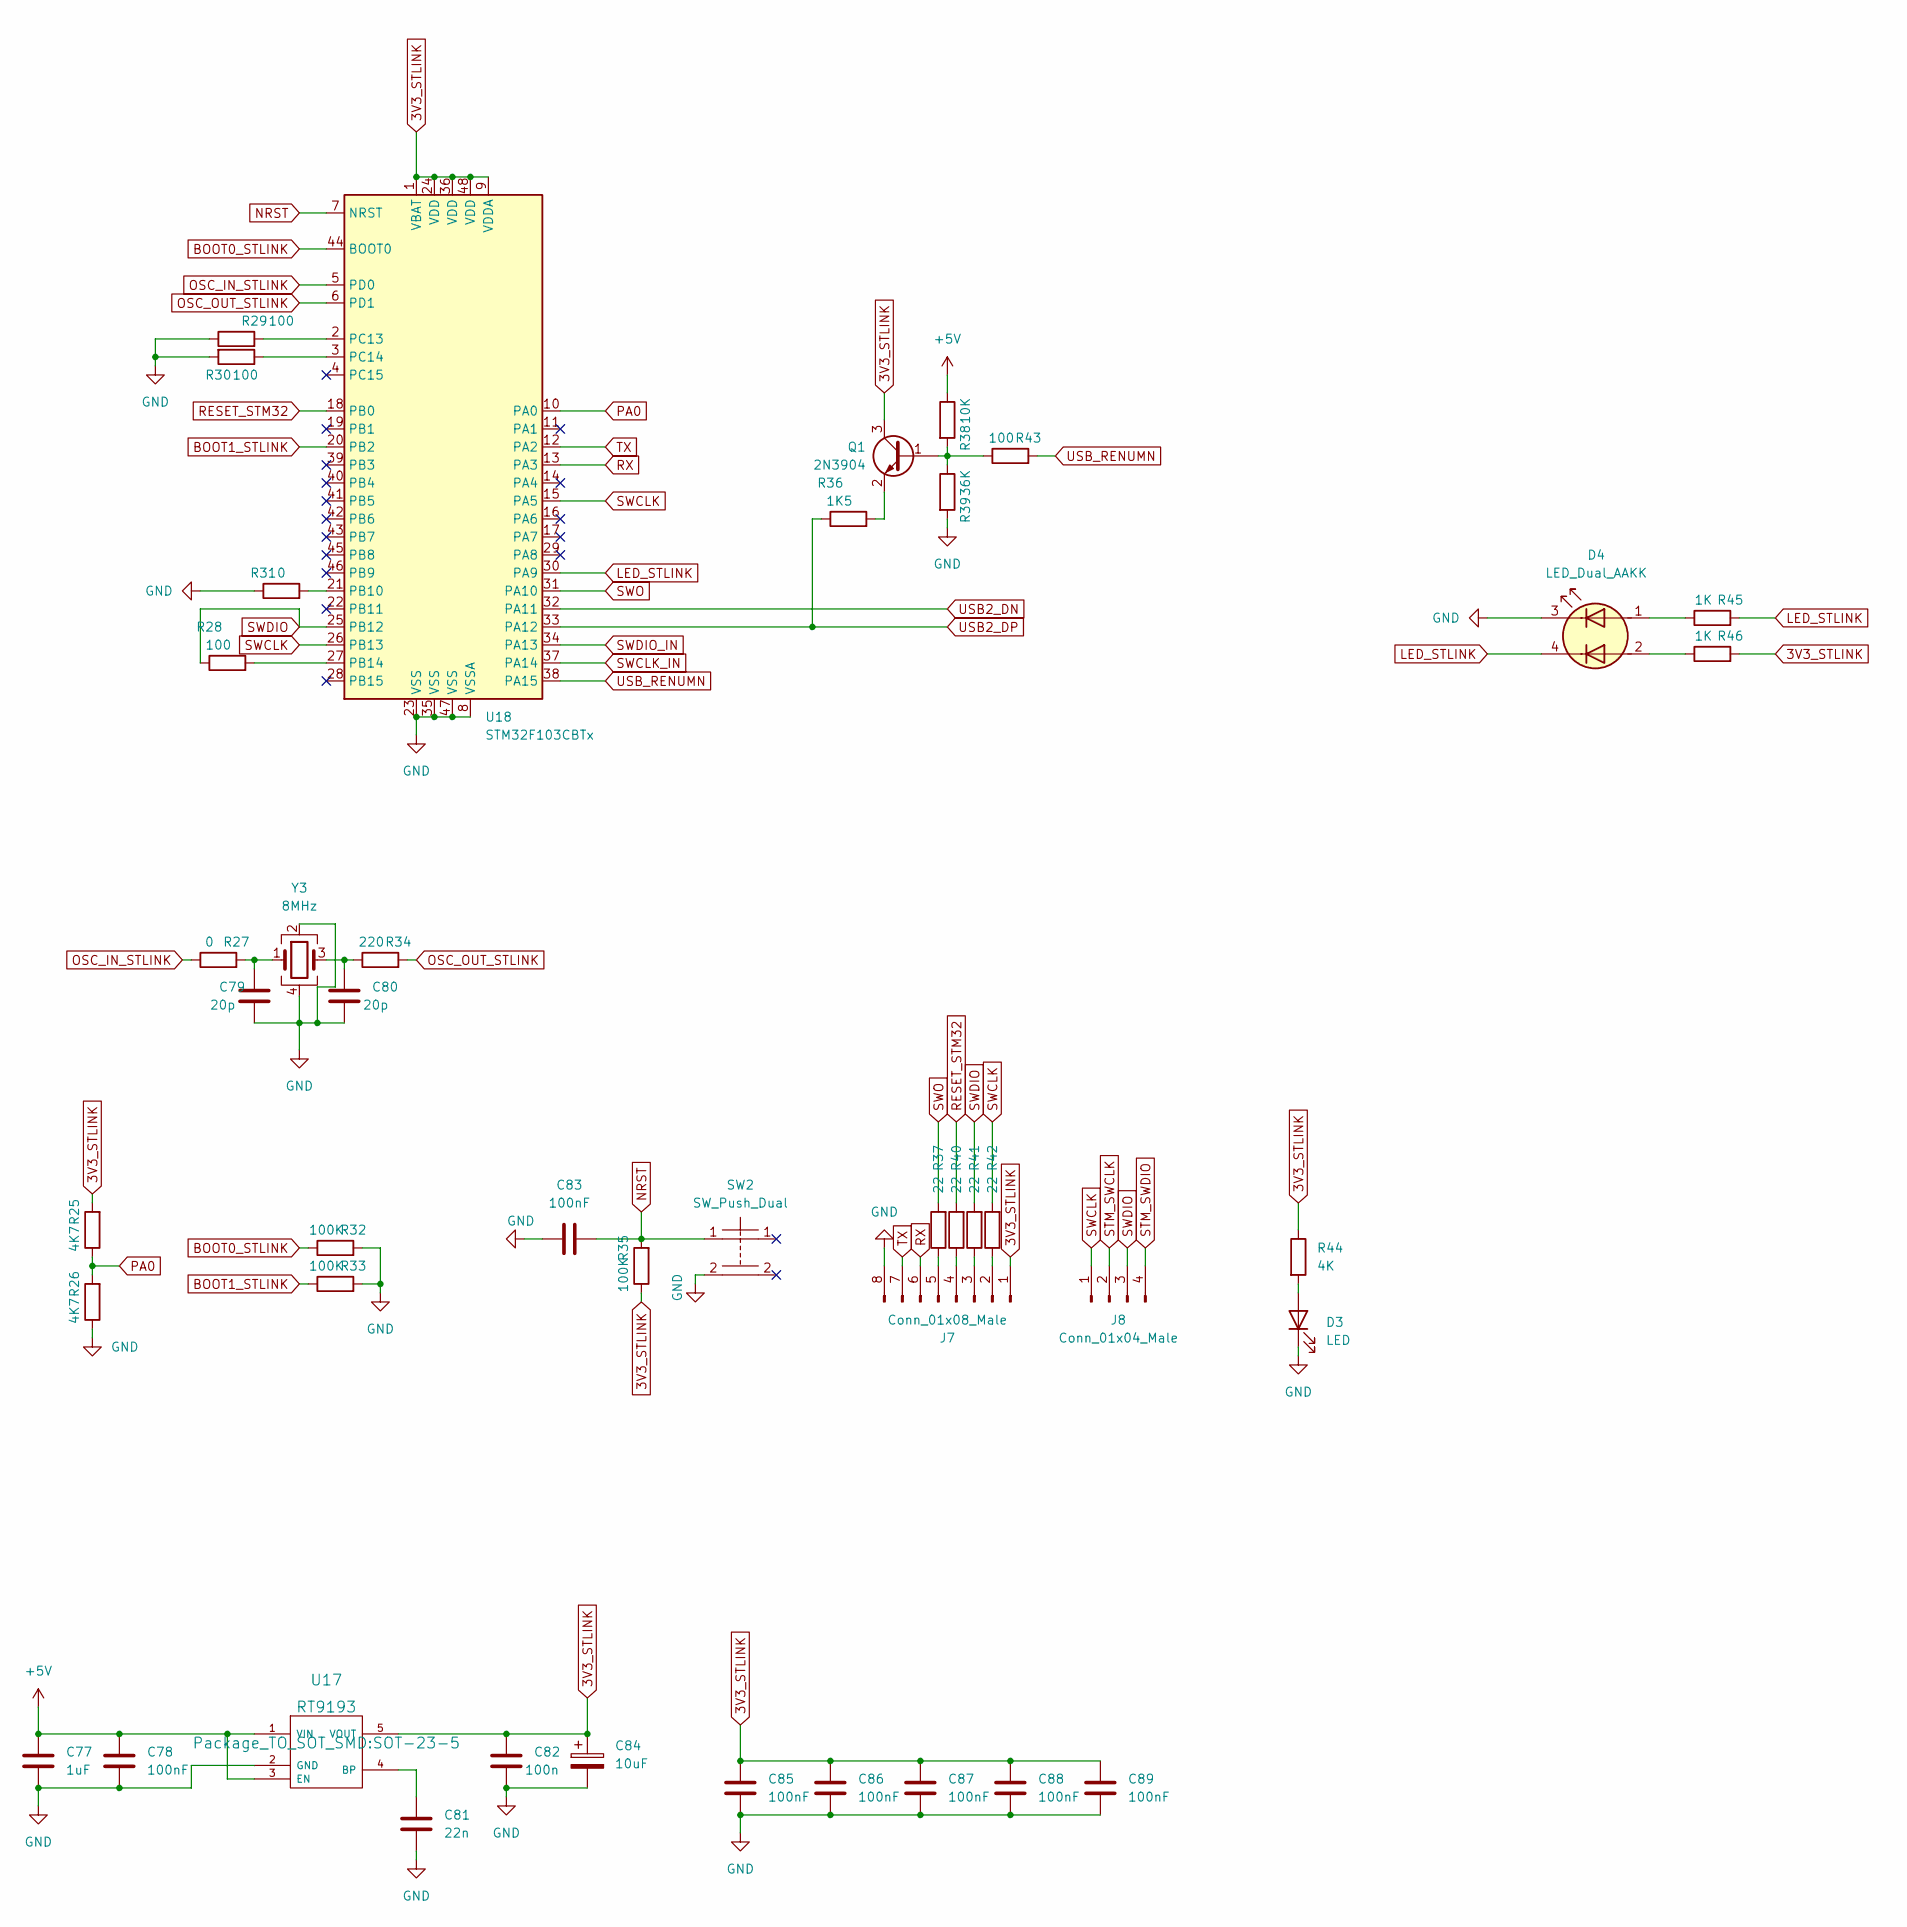
[picture p10: schematic stlink.kicad_sch]

Parts:
C77: 1uF; C_0805_2012Metric_Pad1.18x1.45mm_HandSolder
C78: 100nF; C_0805_2012Metric_Pad1.18x1.45mm_HandSolder
C79, C80: 20p; C_0603_1608Metric_Pad1.08x0.95mm_HandSolder
C81: 22n; C_0805_2012Metric_Pad1.18x1.45mm_HandSolder
C82: 100n; C_0805_2012Metric_Pad1.18x1.45mm_HandSolder
C83, C85, C86, C87, C88, C89: 100nF; C_0603_1608Metric_Pad1.08x0.95mm_HandSolder
C84: 10uF; CP_EIA-1608-08_AVX-J
D3: LED; LED_0805_2012Metric_Pad1.15x1.40mm_HandSolder
D4: LED_Dual_AAKK; LED_RGB_Wuerth-PLCC4_3.2x2.8mm_150141M173100
J7: Conn_01x08_Male; PinSocket_1x08_P2.54mm_Vertical
J8: Conn_01x04_Male; PinSocket_1x04_P2.54mm_Vertical
Q1: 2N3904; SOT-23
R25, R26: 4K7; R_0603_1608Metric_Pad0.98x0.95mm_HandSolder
R27, R31: 0; R_0603_1608Metric_Pad0.98x0.95mm_HandSolder
R28, R29, R30, R43: 100; R_0603_1608Metric_Pad0.98x0.95mm_HandSolder
R32, R33, R35: 100K; R_0603_1608Metric_Pad0.98x0.95mm_HandSolder
R34: 220; R_0603_1608Metric_Pad0.98x0.95mm_HandSolder
R36: 1K5; R_0603_1608Metric_Pad0.98x0.95mm_HandSolder
R37, R40, R41, R42: 22; R_0603_1608Metric_Pad0.98x0.95mm_HandSolder
R38: 10K; R_0603_1608Metric_Pad0.98x0.95mm_HandSolder
R39: 36K; R_0603_1608Metric_Pad0.98x0.95mm_HandSolder
R44: 4K; R_0603_1608Metric_Pad0.98x0.95mm_HandSolder
R45, R46: 1K; R_0603_1608Metric_Pad0.98x0.95mm_HandSolder
SW2: SW_Push_Dual; SW_Push_1P1T_NO_6x6mm_H9.5mm
U17: RT9193; SOT-23-5
U18: STM32F103CBTx; LQFP-48_7x7mm_P0.5mm
Y3: 8MHz; Crystal_SMD_3225-4Pin_3.2x2.5mm

Connections:
3V3_STLINK: C82.1, C84.1, C85.1, C86.1, C87.1, C88.1, C89.1, J7.1, Q1.3 (C), R25.2, R35.1, R44.1, R46.2, U17.5 (VOUT), U18.1 (VBAT), U18.9 (VDDA), U18.24 (VDD), U18.36 (VDD), U18.48 (VDD)
+5V: C77.1, C78.1, R38.1, U17.1 (VIN), U17.3 (EN); also elsewhere on the board
BOOT0_STLINK: R32.1, U18.44 (BOOT0)
BOOT1_STLINK: R33.1, U18.20 (PB2)
GND: C77.2, C78.2, C79.2, C80.2, C81.2, C82.2, C83.1, C84.2, C85.2, C86.2, C87.2, C88.2, C89.2, D3.1 (K), D4.3 (K1), J7.8, R26.1, R29.1, R30.2, R31.1, R32.2, R33.2, R39.2, SW2.2, U17.2 (GND), U18.8 (VSSA), U18.23 (VSS), U18.35 (VSS), U18.47 (VSS), Y3.2, Y3.4; also elsewhere on the board
LED_STLINK: D4.4 (K2), R45.2, U18.30 (PA9)
NRST: C83.2, R35.2, SW2.1, U18.7 (NRST)
unnamed: C79.1, R27.2, Y3.1
unnamed: C80.1, R34.1, Y3.3
unnamed: C81.1, U17.4 (BP)
unnamed: D3.2 (A), R44.2
unnamed: D4.1 (A1), R45.1
unnamed: D4.2 (A2), R46.1
unnamed: J7.2, R42.1
unnamed: J7.3, R41.1
unnamed: J7.4, R40.1
unnamed: J7.5, R37.1
unnamed: Q1.1 (B), R38.2, R39.1, R43.1
unnamed: Q1.2 (E), R36.2
unnamed: R28.2, U18.27 (PB14)
unnamed: R29.2, U18.2 (PC13)
unnamed: R30.1, U18.3 (PC14)
unnamed: R31.2, U18.21 (PB10)
OSC_IN_STLINK: R27.1, U18.5 (PD0)
OSC_OUT_STLINK: R34.2, U18.6 (PD1)
PA0: R25.1, R26.2, U18.10 (PA0); also elsewhere on the board
RX: J7.6, U18.13 (PA3)
STM_SWCLK: J8.2; also elsewhere on the board
STM_SWDIO: J8.4; also elsewhere on the board
SWCLK: J8.1, R42.2, U18.15 (PA5), U18.26 (PB13); also elsewhere on the board
SWCLK_IN: U18.37 (PA14); also elsewhere on the board
SWDIO: J8.3, R28.1, R41.2, U18.25 (PB12); also elsewhere on the board
SWDIO_IN: U18.34 (PA13); also elsewhere on the board
SWO: R37.2, U18.31 (PA10); also elsewhere on the board
TX: J7.7, U18.12 (PA2)
USB2_DN: U18.32 (PA11); also elsewhere on the board
USB2_DP: R36.1, U18.33 (PA12); also elsewhere on the board
USB_RENUMN: R43.2, U18.38 (PA15)

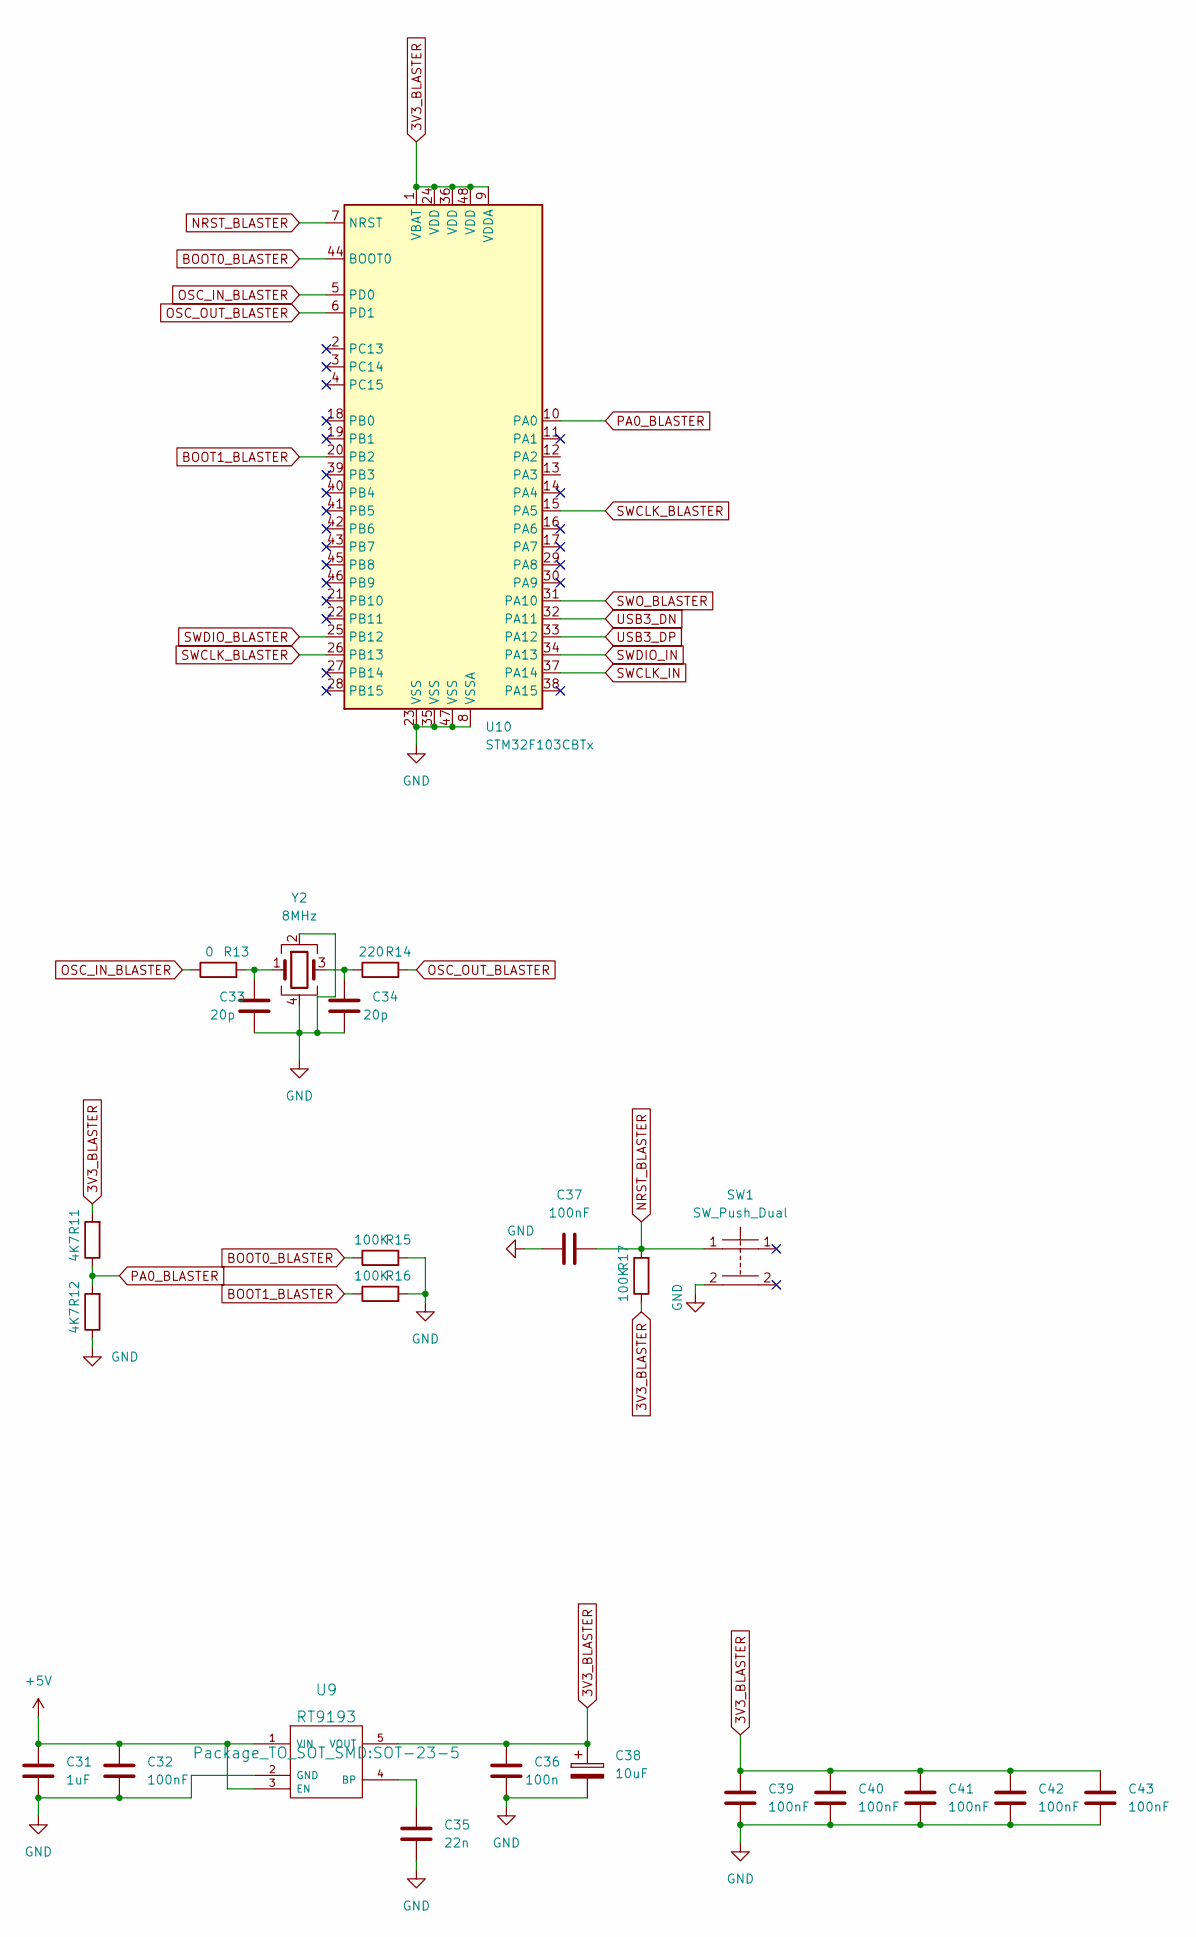
[picture p11: schematic FPGA_Programmer.kicad_sch]

Parts:
C31: 1uF; C_0805_2012Metric_Pad1.18x1.45mm_HandSolder
C32: 100nF; C_0805_2012Metric_Pad1.18x1.45mm_HandSolder
C33, C34: 20p; C_0603_1608Metric_Pad1.08x0.95mm_HandSolder
C35: 22n; C_0805_2012Metric_Pad1.18x1.45mm_HandSolder
C36: 100n; C_0805_2012Metric_Pad1.18x1.45mm_HandSolder
C37, C39, C40, C41, C42, C43: 100nF; C_0603_1608Metric_Pad1.08x0.95mm_HandSolder
C38: 10uF; CP_EIA-1608-08_AVX-J
R11, R12: 4K7; R_0603_1608Metric_Pad0.98x0.95mm_HandSolder
R13: 0; R_0603_1608Metric_Pad0.98x0.95mm_HandSolder
R14: 220; R_0603_1608Metric_Pad0.98x0.95mm_HandSolder
R15, R16, R17: 100K; R_0603_1608Metric_Pad0.98x0.95mm_HandSolder
SW1: SW_Push_Dual; SW_Push_1P1T_NO_6x6mm_H9.5mm
U9: RT9193; SOT-23-5
U10: STM32F103CBTx; LQFP-48_7x7mm_P0.5mm
Y2: 8MHz; Crystal_SMD_3225-4Pin_3.2x2.5mm

Connections:
3V3_BLASTER: C36.1, C38.1, C39.1, C40.1, C41.1, C42.1, C43.1, R11.2, R17.1, U9.5 (VOUT), U10.1 (VBAT), U10.9 (VDDA), U10.24 (VDD), U10.36 (VDD), U10.48 (VDD)
+5V: C31.1, C32.1, U9.1 (VIN), U9.3 (EN); also elsewhere on the board
BOOT0_BLASTER: R15.1, U10.44 (BOOT0)
BOOT1_BLASTER: R16.1, U10.20 (PB2)
GND: C31.2, C32.2, C33.2, C34.2, C35.2, C36.2, C37.1, C38.2, C39.2, C40.2, C41.2, C42.2, C43.2, R12.1, R15.2, R16.2, SW1.2, U9.2 (GND), U10.8 (VSSA), U10.23 (VSS), U10.35 (VSS), U10.47 (VSS), Y2.2, Y2.4; also elsewhere on the board
NRST_BLASTER: C37.2, R17.2, SW1.1, U10.7 (NRST)
unnamed: C33.1, R13.2, Y2.1
unnamed: C34.1, R14.1, Y2.3
unnamed: C35.1, U9.4 (BP)
OSC_IN_BLASTER: R13.1, U10.5 (PD0)
OSC_OUT_BLASTER: R14.2, U10.6 (PD1)
PA0_BLASTER: R11.1, R12.2, U10.10 (PA0)
SWCLK_BLASTER: U10.15 (PA5), U10.26 (PB13)
SWCLK_IN: U10.37 (PA14); also elsewhere on the board
SWDIO_BLASTER: U10.25 (PB12)
SWDIO_IN: U10.34 (PA13); also elsewhere on the board
SWO_BLASTER: U10.31 (PA10)
USB3_DN: U10.32 (PA11); also elsewhere on the board
USB3_DP: U10.33 (PA12); also elsewhere on the board

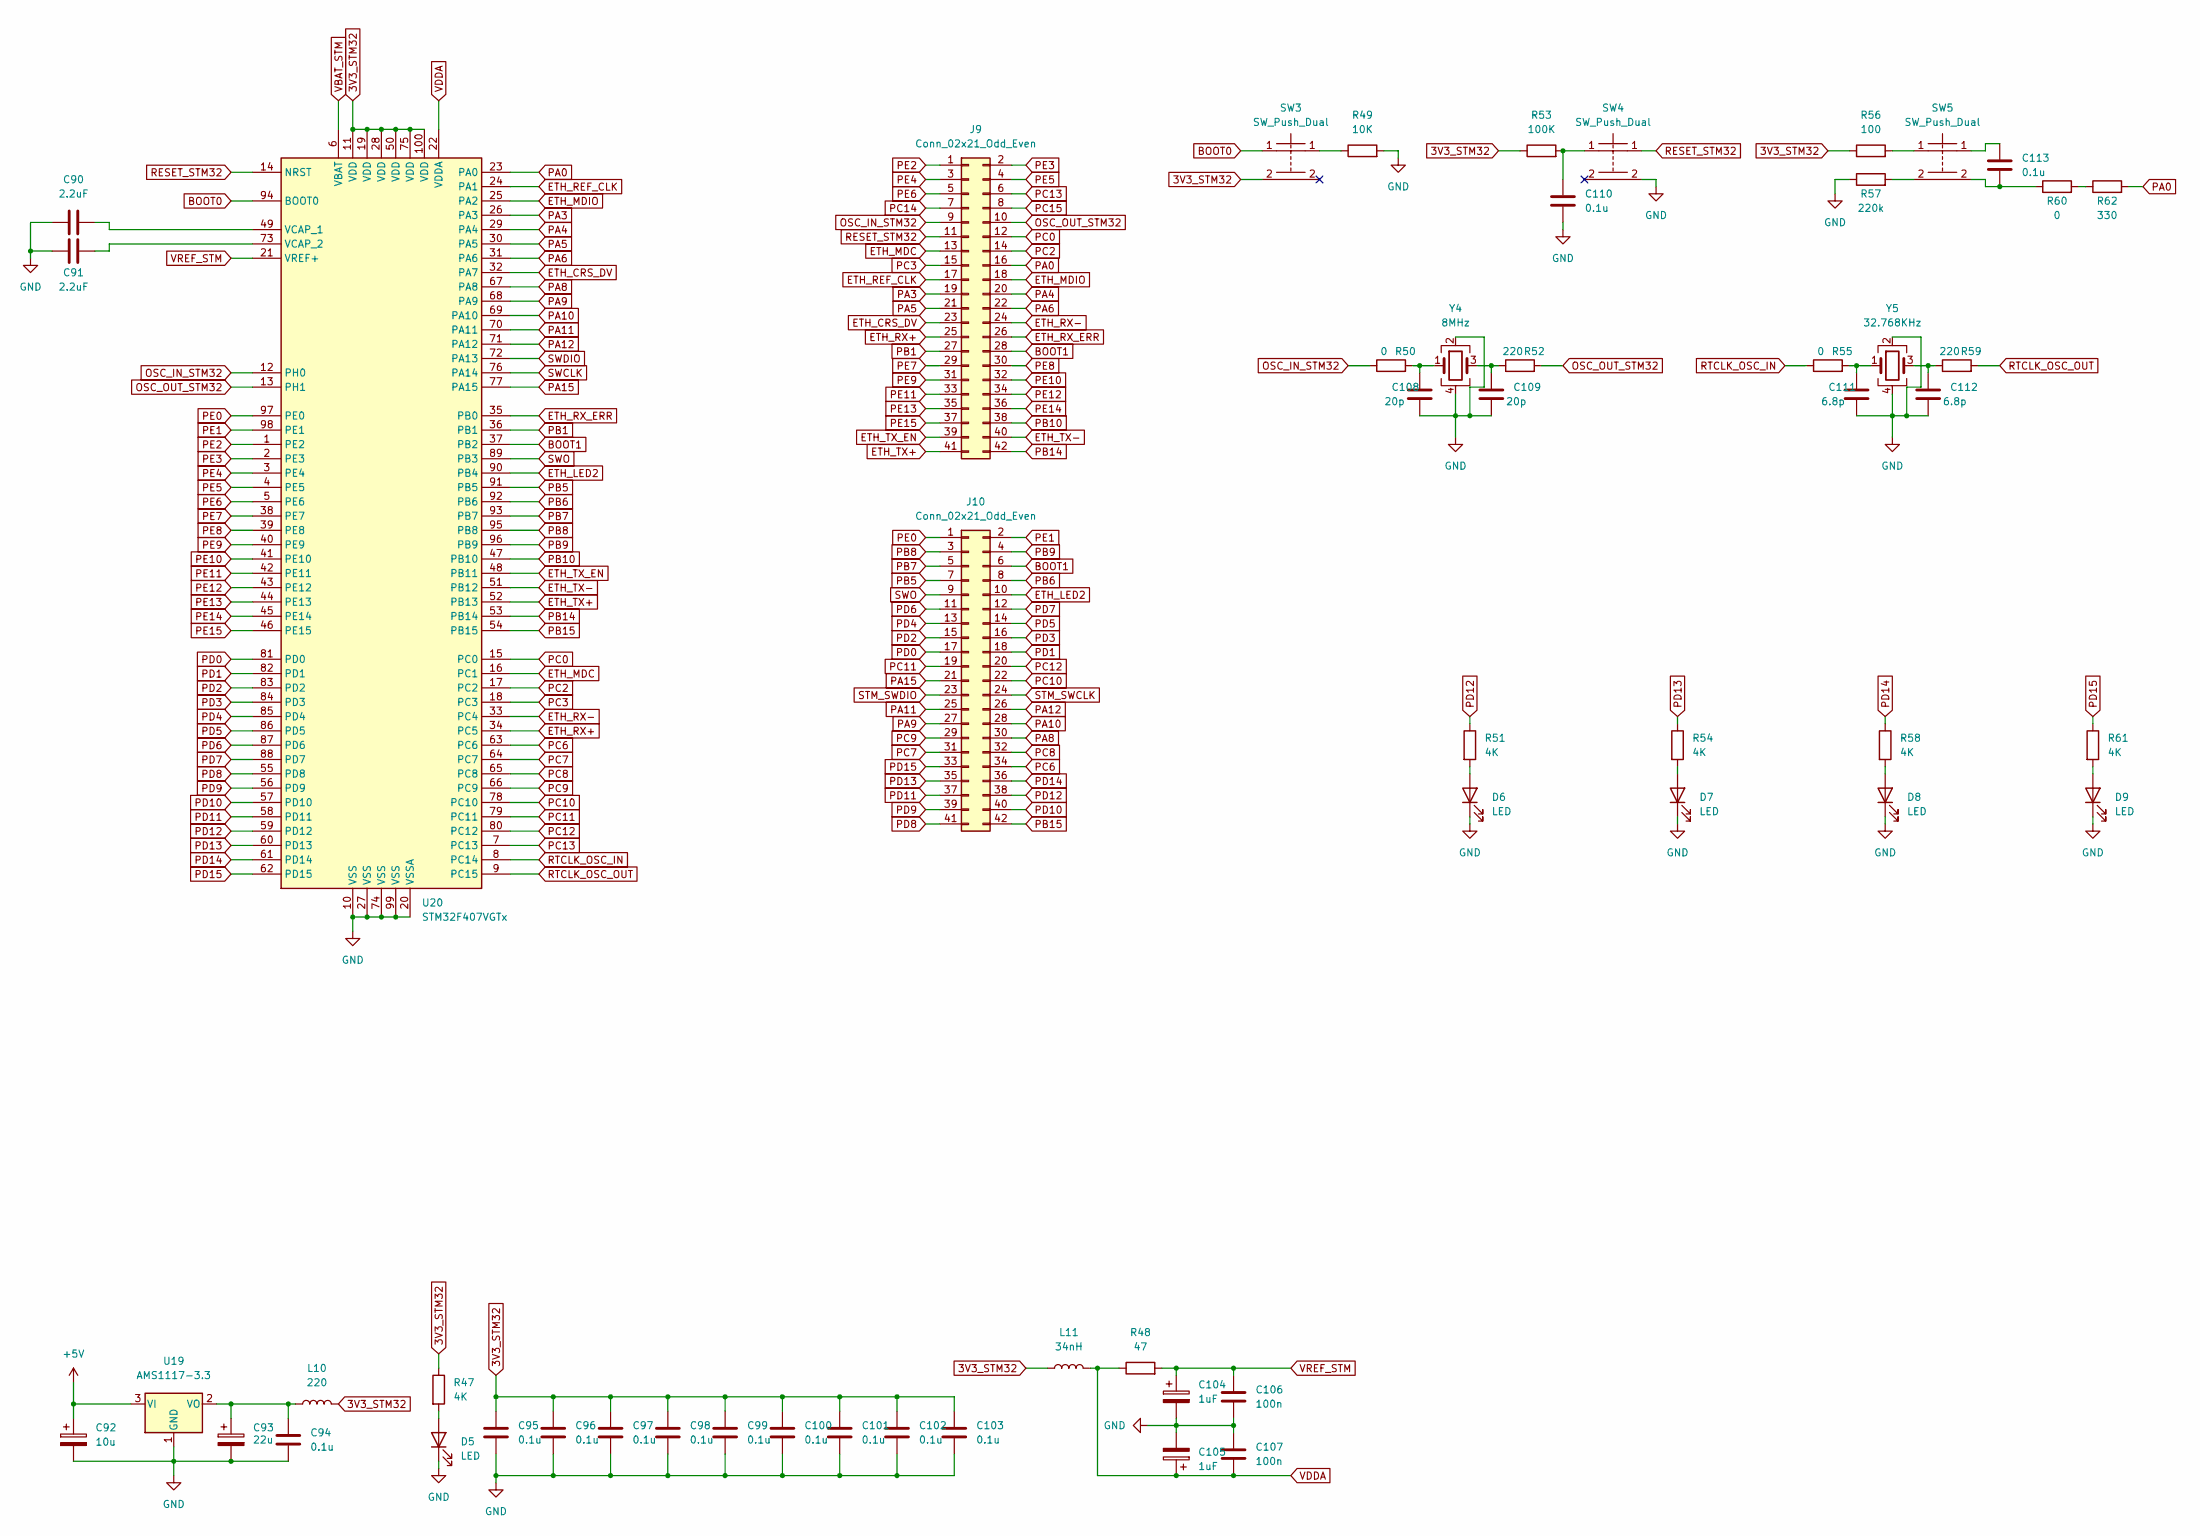
[picture p12: schematic stm32f407.kicad_sch]

Parts:
C90, C91: 2.2uF; C_0603_1608Metric_Pad1.08x0.95mm_HandSolder
C92: 10u; CP_EIA-6032-15_Kemet-U_Pad2.25x2.35mm_HandSolder
C93: 22u; CP_EIA-6032-15_Kemet-U_Pad2.25x2.35mm_HandSolder
C94: 0.1u; C_0805_2012Metric_Pad1.18x1.45mm_HandSolder
C95, C96, C97, C98, C99, C100, C101, C102, C103, C110, C113: 0.1u; C_0603_1608Metric_Pad1.08x0.95mm_HandSolder
C104, C105: 1uF; C_0805_2012Metric_Pad1.18x1.45mm_HandSolder
C106, C107: 100n; C_0603_1608Metric_Pad1.08x0.95mm_HandSolder
C108, C109: 20p; C_0603_1608Metric_Pad1.08x0.95mm_HandSolder
C111, C112: 6.8p; C_0603_1608Metric_Pad1.08x0.95mm_HandSolder
D5, D6, D7, D8, D9: LED; LED_0805_2012Metric_Pad1.15x1.40mm_HandSolder
J9, J10: Conn_02x21_Odd_Even; PinHeader_2x21_P2.54mm_Vertical
L10: 220; L_2010_5025Metric_Pad1.52x2.65mm_HandSolder
L11: 34nH; L_0805_2012Metric
R47, R51, R54, R58, R61: 4K; R_0603_1608Metric_Pad0.98x0.95mm_HandSolder
R48: 47; R_0603_1608Metric_Pad0.98x0.95mm_HandSolder
R49: 10K; R_0603_1608Metric_Pad0.98x0.95mm_HandSolder
R50, R55, R60: 0; R_0603_1608Metric_Pad0.98x0.95mm_HandSolder
R52, R59: 220; R_0603_1608Metric_Pad0.98x0.95mm_HandSolder
R53: 100K; R_0603_1608Metric_Pad0.98x0.95mm_HandSolder
R56: 100; R_0603_1608Metric_Pad0.98x0.95mm_HandSolder
R57: 220k; R_0603_1608Metric_Pad0.98x0.95mm_HandSolder
R62: 330; R_0603_1608Metric_Pad0.98x0.95mm_HandSolder
SW3, SW4, SW5: SW_Push_Dual; SW_Push_1P1T_NO_6x6mm_H9.5mm
U19: AMS1117-3.3; SOT-223-3_TabPin2
U20: STM32F407VGTx; LQFP-100_14x14mm_P0.5mm
Y4: 8MHz; Crystal_SMD_3225-4Pin_3.2x2.5mm
Y5: 32.768KHz; Crystal_SMD_3225-4Pin_3.2x2.5mm

Connections:
3V3_STM32: C95.1, C96.1, C97.1, C98.1, C99.1, C100.1, C101.1, C102.1, C103.1, L10.2, L11.1, R47.1, R53.1, R56.1, SW3.2, U20.11 (VDD), U20.19 (VDD), U20.28 (VDD), U20.50 (VDD), U20.75 (VDD), U20.100 (VDD)
+5V: C92.1, U19.3 (VI); also elsewhere on the board
BOOT1: J9.28, J10.6, U20.37 (PB2)
ETH_CRS_DV: J9.23, U20.32 (PA7); also elsewhere on the board
ETH_LED2: J10.10, U20.90 (PB4); also elsewhere on the board
ETH_MDC: J9.13, U20.16 (PC1); also elsewhere on the board
ETH_MDIO: J9.18, U20.25 (PA2); also elsewhere on the board
ETH_REF_CLK: J9.17, U20.24 (PA1); also elsewhere on the board
ETH_RX+: J9.25, U20.34 (PC5); also elsewhere on the board
ETH_RX-: J9.24, U20.33 (PC4); also elsewhere on the board
ETH_RX_ERR: J9.26, U20.35 (PB0); also elsewhere on the board
ETH_TX+: J9.41, U20.52 (PB13); also elsewhere on the board
ETH_TX-: J9.40, U20.51 (PB12); also elsewhere on the board
ETH_TX_EN: J9.39, U20.48 (PB11); also elsewhere on the board
GND: C90.1, C91.2, C92.2, C93.2, C94.2, C95.2, C96.2, C97.2, C98.2, C99.2, C100.2, C101.2, C102.2, C103.2, C104.2, C105.2, C106.2, C107.1, C108.2, C109.2, C110.2, C111.2, C112.2, D5.1 (K), D6.1 (K), D7.1 (K), D8.1 (K), D9.1 (K), R49.2, R57.1, SW4.2, U19.1 (GND), U20.10 (VSS), U20.20 (VSSA), U20.27 (VSS), U20.74 (VSS), U20.99 (VSS), Y4.2, Y4.4, Y5.2, Y5.4; also elsewhere on the board
unnamed: C90.2, U20.49 (VCAP_1)
unnamed: C91.1, U20.73 (VCAP_2)
unnamed: C93.1, C94.1, L10.1, U19.2 (VO)
unnamed: C108.1, R50.2, Y4.1
unnamed: C109.1, R52.1, Y4.3
unnamed: C111.1, R55.2, Y5.1
unnamed: C112.1, R59.1, Y5.3
unnamed: D5.2 (A), R47.2
unnamed: D6.2 (A), R51.2
unnamed: D7.2 (A), R54.2
unnamed: D8.2 (A), R58.2
unnamed: D9.2 (A), R61.2
unnamed: R60.2, R62.1
OSC_IN_STM32: J9.9, R50.1, U20.12 (PH0)
OSC_OUT_STM32: J9.10, R52.2, U20.13 (PH1)
PA0: J9.16, R62.2, U20.23 (PA0); also elsewhere on the board
PA3: J9.19, U20.26 (PA3)
PA4: J9.20, U20.29 (PA4)
PA5: J9.21, U20.30 (PA5)
PA6: J9.22, U20.31 (PA6)
PA8: J10.30, U20.67 (PA8)
PA9: J10.27, U20.68 (PA9)
PA10: J10.28, U20.69 (PA10)
PA11: J10.25, U20.70 (PA11); also elsewhere on the board
PA12: J10.26, U20.71 (PA12); also elsewhere on the board
PA15: J10.21, U20.77 (PA15)
PB1: J9.27, U20.36 (PB1)
PB5: J10.7, U20.91 (PB5)
PB6: J10.8, U20.92 (PB6)
PB7: J10.5, U20.93 (PB7)
PB8: J10.3, U20.95 (PB8)
PB9: J10.4, U20.96 (PB9)
PB10: J9.38, U20.47 (PB10)
PB14: J9.42, U20.53 (PB14)
PB15: J10.42, U20.54 (PB15)
PC0: J9.12, U20.15 (PC0)
PC2: J9.14, U20.17 (PC2)
PC3: J9.15, U20.18 (PC3)
PC6: J10.34, U20.63 (PC6)
PC7: J10.31, U20.64 (PC7)
PC8: J10.32, U20.65 (PC8)
PC9: J10.29, U20.66 (PC9)
PC10: J10.22, U20.78 (PC10)
PC11: J10.19, U20.79 (PC11)
PC12: J10.20, U20.80 (PC12)
PC13: J9.6, U20.7 (PC13)
PC14: J9.7
PC15: J9.8
PD0: J10.17, U20.81 (PD0)
PD1: J10.18, U20.82 (PD1)
PD2: J10.15, U20.83 (PD2)
PD3: J10.16, U20.84 (PD3)
PD4: J10.13, U20.85 (PD4)
PD5: J10.14, U20.86 (PD5)
PD6: J10.11, U20.87 (PD6); also elsewhere on the board
PD7: J10.12, U20.88 (PD7); also elsewhere on the board
PD8: J10.41, U20.55 (PD8)
PD9: J10.39, U20.56 (PD9)
PD10: J10.40, U20.57 (PD10)
PD11: J10.37, U20.58 (PD11)
PD12: J10.38, R51.1, U20.59 (PD12)
PD13: J10.35, R54.1, U20.60 (PD13)
PD14: J10.36, R58.1, U20.61 (PD14)
PD15: J10.33, R61.1, U20.62 (PD15)
PE0: J10.1, U20.97 (PE0)
PE1: J10.2, U20.98 (PE1)
PE2: J9.1, U20.1 (PE2)
PE3: J9.2, U20.2 (PE3)
PE4: J9.3, U20.3 (PE4)
PE5: J9.4, U20.4 (PE5)
PE6: J9.5, U20.5 (PE6)
PE7: J9.29, U20.38 (PE7)
PE8: J9.30, U20.39 (PE8)
PE9: J9.31, U20.40 (PE9)
PE10: J9.32, U20.41 (PE10)
PE11: J9.33, U20.42 (PE11)
PE12: J9.34, U20.43 (PE12)
PE13: J9.35, U20.44 (PE13)
PE14: J9.36, U20.45 (PE14)
PE15: J9.37, U20.46 (PE15)
RTCLK_OSC_IN: R55.1, U20.8 (PC14)
RTCLK_OSC_OUT: R59.2, U20.9 (PC15)
STM_SWCLK: J10.24; also elsewhere on the board
STM_SWDIO: J10.23; also elsewhere on the board
SWCLK: U20.76 (PA14); also elsewhere on the board
SWDIO: U20.72 (PA13); also elsewhere on the board
SWO: J10.9, U20.89 (PB3); also elsewhere on the board
VBAT_STM: U20.6 (VBAT)
VDDA: C105.1, C107.2, L11.2, R48.1, U20.22 (VDDA)
VREF_STM: C104.1, C106.1, R48.2, U20.21 (VREF+)

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
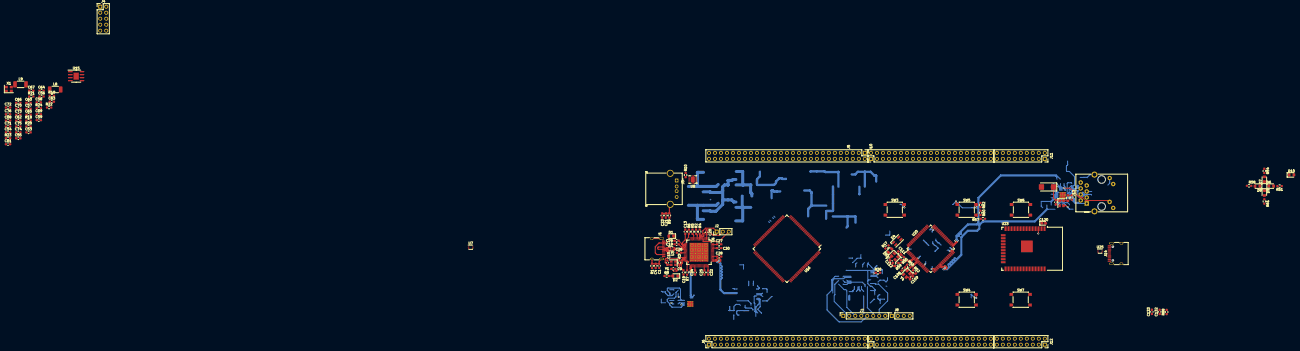
[picture p13: board project.kicad_pcb from above]

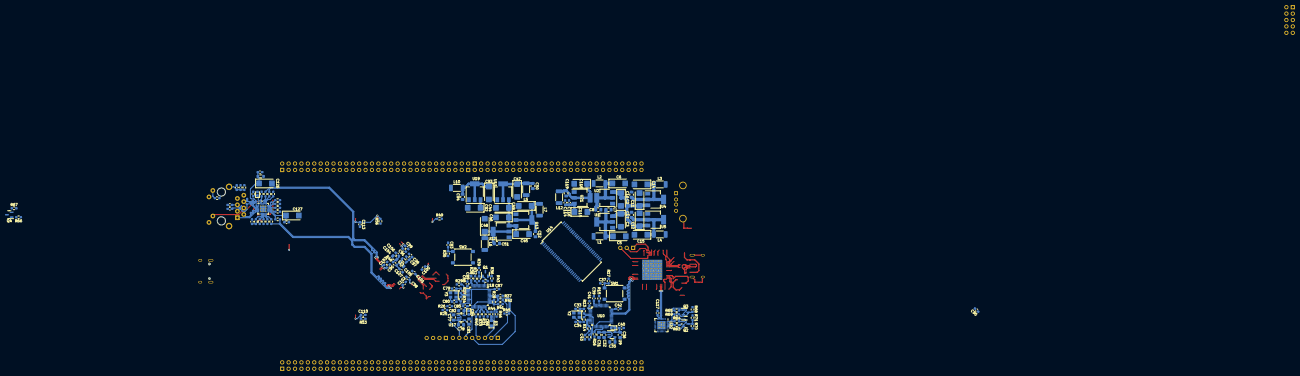
[picture p14: board project.kicad_pcb from below]

Board: 4 copper layers, 305 parts (177 on the bottom side), 367 nets.
