AN1ME2U/diploma/(commit log)

2022-04-16 Add all done for a moment
    [FPGA.kicad_sch, FPGA_Programmer.kicad_sch, atempt10.dsn, atempt11.dsn, atempt12.dsn, atempt13.dsn, atempt14.dsn, atempt15.dsn]
2022-05-01 еще одни дополнения
    [FPGA.kicad_sch, FPGA_Programmer.kicad_sch, esp32.kicad_sch, project.kicad_sch, stlink.kicad_sch, stm32_ex.kicad_sch, stm32f407.kicad_sch]
